HaiPaYanZi/Smart-Farm-Edge-Node/项目过程/原理图_conv.jpg

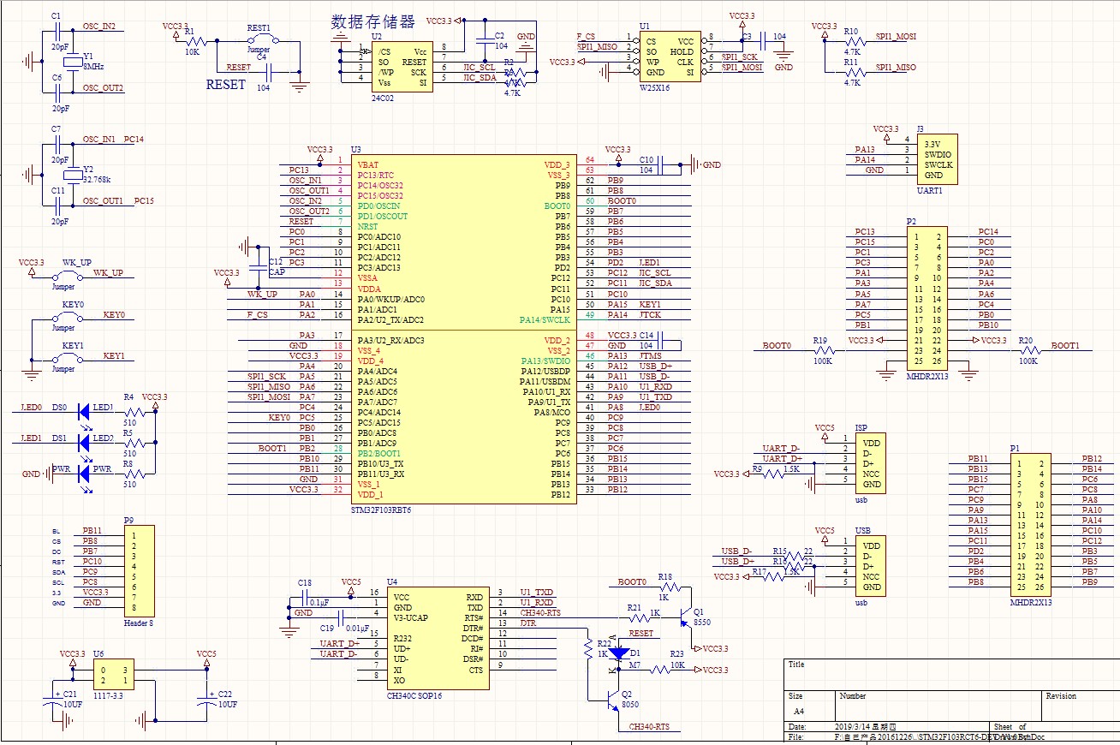
项目过程/原理图_conv.jpg
