HaiPaYanZi/Smart-Farm-Edge-Node/docs/03-详细设计说明书.md

# 详细设计说明书（LLD）

## 文档控制信息

| 项 | 内容 |
|---|---|
| 项目名称 | 温室环境智能控制节点 |
| 文档编号 | GWN-LLD-003 |
| 版本 | V1.0 |
| 作者 | 郑权 |
| 日期 | 2026-07-31 |
| 状态 | 已评审 |
| 上游文档 | 总体设计方案（GWN-HLD-002） |

---

## 1. 引言

本文档定义各模块的详细设计：算法、状态机、数据结构、关键函数接口与实现要点，编码以此为准。

---

## 2. PID 控制器设计（核心模块）

### 2.1 算法选择：位置式 PID + 抗积分饱和

```
u(k) = Kp·e(k) + Ki·Σe(i) + Kd·[e(k) - e(k-1)]
其中 e(k) = 目标温度 - 当前温度
输出 u(k) 限幅至 [0, 100]（%占空比）
```

### 2.2 实现要点

| 要点 | 实现 |
|---|---|
| 抗积分饱和 | 输出饱和（u=100 或 u=0）时，积分项停止累加（clamping 法） |
| 输出限幅 | 0~100%，双限幅 |
| 微分滤波（可选） | 对 e 做一阶低通（α=0.2）抑制噪声微分放大 |
| 整定方式 | 试凑法：先 P 后 I 再 D；现场演示"调 P 看风机抖动" |
| 采样/控制周期 | 控制任务 100ms 周期调用；与采集 200ms 解耦（PID 用最新快照） |
| 参数存储 | Kp: 0.1~50.0（默认 8.0）、Ki: 0.01~5.0（默认 0.3）、Kd: 0.1~20.0（默认 2.0），存 Flash，可远程改 |

### 2.3 数据结构

```c
typedef struct {
    float kp, ki, kd;
    float target;        // 目标温度(℃)
    float integral;      // 积分累加
    float prev_err;      // 上次误差(用于微分)
    float out;           // 输出 0~100
    float out_min, out_max; // 限幅(0,100)
    uint8_t  enabled;    // 使能
} pid_ctrl_t;
```

### 2.4 接口

```c
void pid_init(pid_ctrl_t *p, float kp, float ki, float kd);
float pid_update(pid_ctrl_t *p, float target, float feedback);
void pid_reset(pid_ctrl_t *p);   // 清积分(模式切换/参数变更时调用)
```

---

## 3. 规则引擎设计

### 3.1 规则表结构（周期 500ms 评估，控制任务内）

```c
typedef struct {
    uint16_t sensor_id;      // 输入源: SENSOR_TEMP/HUMI/LIGHT/SOIL
    float    threshold_hi;   // 上限阈值
    float    threshold_lo;   // 下限阈值
    float    hysteresis;     // 回差
    uint8_t  actuator_id;    // 执行器: ACT_FAN/ACT_LIGHT/ACT_PUMP
    uint8_t  action_hi;      // 高于上限的动作: 0无/1开/2关
    uint8_t  action_lo;      // 低于下限的动作
    uint8_t  mode;           // 0=禁用 1=使能(自动)
} rule_t;
```

### 3.2 预置规则（可在 Flash 中修改）

| 规则 | 输入 | 逻辑 | 执行器 |
|---|---|---|---|
| R1 通风（PID） | 温度 | PID 连续调节，滞回下限：温度<目标-2℃ 停转 | 风机 |
| R2 补光 | 光照 | <2000lx 开；>3000lx 关（回差 1000） | 补光灯 |
| R3 灌溉 | 土壤湿度 | <30% 开；>45% 关（回差 15） | 水泵 |

### 3.3 执行器输出映射

| 执行器 | 输出方式 | 手动模式替代 |
|---|---|---|
| 风机 | PID 输出 → 占空比 | 40006 直接写占空比 |
| 补光灯 | 规则开/关 → 占空比 80% 或 0% | 线圈 00002 |
| 水泵 | 规则开/关 → GPIO | 线圈 00001 |

---

## 4. 堵转检测与故障管理

### 4.1 堵转检测逻辑（反馈任务 + 控制任务协作）

```
状态: NORMAL → 输出占空比>30% → 启动检测窗口(3s)
      3s 内累计霍尔脉冲 < 阈值(如 5 个) → 判定堵转
      → FAULT(堵转): 停机(占空比0) + 蜂鸣器报警 + Modbus 状态位置位
      → 10s 后自动重试: 重新启动 → 再堵转 → FAULT(严重) → 停止自动重试
```

### 4.2 传感器失效判定

- 软件 I2C 读取失败连续 5 次（≈1s）→ 该传感器标记失效；
- 温度传感器失效 → 进入安全态：风机 30% 固定占空比（SAF2 哲学）；
- 光照/土壤失效 → 对应规则禁用，其余继续运行（降级）；
- 全部传感器失效 → FAULT(致命) → 复位进待机。

### 4.3 故障等级与状态字（上报 Modbus 30007）

```
bit0: 模式自动  bit1: 模式手动  bit2: 待机  bit3: 故障中  bit4: 恢复中
bit5: 堵转     bit6: 传感器失效  bit7: 上联断线  bit8: SD失败
```

---

## 5. Modbus 从机设计（FreeModbus 移植要点）

### 5.1 移植要点

- `eMBInit(MB_RTU, addr, 0, 9600, MB_PAR_NONE)`；
- RS485 DE 方向控制：UART TX 完成回调中置位/清零 DE（PA8）；
- `eMBPoll()` 放 Modbus 任务主循环，周期 ≥1ms；
- 保持寄存器/输入寄存器数组：`usRegHoldingBuf[16]`、`usRegInputBuf[8]`，读写回调里同步快照/参数区（互斥量保护）；
- **写回调中禁止执行耗时操作**：只更新参数区标志，实际生效由控制任务下次周期加载。

### 5.2 寄存器读写回调

```c
eMBErrorCode eMBRegHoldingCB(UCHAR *pucRegBuffer, USHORT usAddress,
                             USHORT usNRegs, eMBRegisterMode eMode);
// usAddress 为 0 基偏移，对应寄存器表 C1 文档
```

---

## 6. 数据存储设计

### 6.1 参数区（内部 Flash，模拟 NVS）

```
Flash 页4 (0x0800F000) 参数区1  | 页5 参数区2  ← 双页轮换，防掉电写坏
布局: 头(magic 0xA5A5 + crc16 + version) + 参数结构体
参数结构体: PID×3 + 目标温度 + 各阈值/回差 + 模式 + 从站地址 + 版本号
```

> 勘误(V1.2)：RCT6 为高密度器件，Flash 页大小 2KB，"页4/页5"应为"第 30/31 页"
> (0x0800F000/0x0800F800)。实现按地址执行，与程序区(约 40KB 内)远离，互不干扰。

写策略：Modbus 修改参数 → 置 dirty 标志 → 控制任务空闲时批量写，写前关中断。

### 6.2 SD 卡日志格式（CSV，按天分文件）

```
2026-07-31.csv
时间戳,温度,湿度,光照,土壤,实际转速,目标转速,模式,状态字,事件
2026-07-31 14:00:01,28.4,65.2,3200,41,1200,1500,AUTO,0x0000,-
2026-07-31 14:00:05,28.9,64.8,3210,40,1500,1500,AUTO,0x0020,FAN_STALL
```

- 写入：日志队列攒 16 条 → 一次性 f_write；
- 滚动：单文件 >512KB 时新建当天第 2 个文件。

---

## 7. OLED 显示设计（SSD1306）

| 页 | 内容 |
|---|---|
| 主页面 | 温度/湿度/光照/土壤 四行实时值 |
| 控制页 | 目标转速/实际转速/占空比/模式 |
| 状态页 | 状态字解析(自动/手动/故障...) + 报警闪烁 |

按键（板载 SW2/SW3，PC8/PC9）：KEY1 翻页，KEY2 切换 自动/手动。（V1.1 实物适配）

---

## 8. OTA 升级详细设计（见 C2 协议，此处为应用侧流程）

> 勘误 V1.3：升级触发寄存器为 **40020=0x5A5A**（原文 40011 与灌溉回差冲突，以 06 文档为准）；
> 页大小 2KB；升级通道 USART1（见 07 文档 V1.1 勘误）。

```
应用收到"升级指令"(40020=0x5A5A，或调试命令 ota)
  → 写升级标志区(0x08003000, upgrade_req=1) → 200ms 后软复位(Modbus 应答先发完)
Boot: 查标志 → 走升级流程 → 收分包写对侧区(2KB页) → CRC32校验 → 切标志 → 跳转
失败路径: 收包超时/校验失败 → 保持原区 → 故障码 0x0302 → 恢复运行
```

---

## 9. 关键函数接口汇总

| 模块 | 函数 | 说明 |
|---|---|---|
| 采集 | `void sensor_read_all(void)` | 200ms 周期，写入快照 |
| 控制 | `void control_tick(void)` | 100ms：状态机+规则+PID+输出 |
| 反馈 | `uint16_t fan_get_rpm(void)` | 霍尔计数换算 RPM |
| 故障 | `void fault_report(uint8_t level, uint16_t code)` | 分级处理+报警+日志 |
| 存储 | `void param_load(void) / param_save(void)` | Flash 参数读写 |
| 日志 | `void log_push(const char *fmt, ...)` | 进队列，日志任务落盘 |
| Modbus | `void modbus_task(void *arg)` | eMBPoll 循环 |
| 显示 | `void display_update(void)` | 500ms 刷新当前页 |

---

## 10. 变更记录

| 版本 | 日期 | 变更内容 | 变更人 |
|---|---|---|---|
| V1.0 | 2026-07-31 | 首次发布 | 郑权 |
| V1.1 | 2026-08-06 | 按键改用板载 SW2/SW3(PC8/PC9)，见 04 文档 V1.1 | 郑权 |
| V1.2 | 2026-08-14 | 节点 1.4/1.6 实现确认：① §2 PID 落地——clamping 抗积分饱和(输出饱和时积分**保持不动**而非清零)、滞回停转区间每拍 PID_Reset、温度失效安全态固定 30%；② §6.1 参数区落地——param.c 统一参数结构 + nvs.c 双区轮换(CRC16+序号+版本头，防抖 2s 落盘)，40008~40011 阈值收编参数区；③ §6.1 勘误——页号应为第 30/31 页(2KB/页) | 郑权 |
| V1.3 | 2026-08-15 | 节点 1.7 OTA 落地确认：① §8 升级触发寄存器勘误 40011→40020；② App 链接基址 = 分区+0x200(固件头段 512B)，向量表按运行地址自适应(链接器符号 Image$$ER_IROM1$$Base)；③ 升级请求写标志区 0x08003000(upgrade_req=1)，200ms 延时复位保证 Modbus 应答发出；④ Boot 8KB 寄存器级实现(USART1 通道/CRC16 帧校验/CRC32 全片校验/5s 超时回滚) | 郑权 |
