HaiPaYanZi/Smart-Farm-Edge-Node/docs/10-测试用例与报告.md

# 测试用例与测试报告

## 文档控制信息

| 项 | 内容 |
|---|---|
| 项目名称 | 温室环境智能控制节点 |
| 文档编号 | GWN-TR-010 |
| 版本 | V1.0 |
| 作者 | 郑权 |
| 日期 | 2026-07-31 |
| 状态 | 进行中（执行记录随测试推进填写） |
| 测试计划 | GWN-TP-009 |

> 说明：以下为用例全集。执行时复制"执行记录"列填写实际结果；未执行用例标记"待执行"。**报告中的测试数据是面试举证材料，务必真实记录。**

---

## 1. 功能测试用例（F 系列）

| 编号 | 用例 | 前置条件 | 步骤 | 预期结果 | 执行记录 |
|---|---|---|---|---|---|
| F01 | 温湿度采集 | 模块平台 | 上电观察 OLED/日志 | 温度/湿度读数与比对仪表偏差 <±0.5℃/±3%RH | |
| F02 | 光照采集 | 手电筒照度变化 | 遮挡/照射 BH1750 | 读数随光照线性变化，量程内不溢出 | |
| F03 | 土壤湿度采集 | 干燥/湿土 | 传感器插入不同湿度土 | 读数变化趋势正确，无跳变毛刺 | |
| F04 | 风机开环调速 | 手动模式 | 40006 写 20/50/80% | 占空比变化，转速随占空比上升，20kHz 无啸叫 | |
| F05 | PID 闭环 | AUTO 模式 | 目标 25℃，用热风枪升/降温度 | 温度趋近目标，稳态误差 ≤±1℃ | |
| F06 | 滞回停转 | 温度低于目标-2℃ | 观察风机 | 风机彻底停转，无频繁启停 | |
| F07 | 补光规则 | 手动改变光照 | 光照 <2000lx | 补光灯开，>3000lx 关 | |
| F08 | 灌溉规则 | 土壤湿度变化 | 湿度 <30% | 水泵继电器吸合，>45% 释放 | |
| F09 | 模式切换 | Modbus 写 40005 | 0/1/2 轮换 | OLED 与状态字同步变化，手动模式 PID 停算 | |
| F10 | Modbus 读输入 | ModbusPoll | 读 30001~30011 | 与 OLED 显示一致 | |
| F11 | Modbus 写参数 | 写 40001~40004 | 改 Kp/目标温度 | 下周期生效，掉电后保持 | |
| F12 | SD 日志 | 跑机 1h | 检查 SD 文件 | 每采集周期一条记录，CSV 格式正确 | |
| F13 | OLED 三页切换 | 按键 | 翻页 | 主/控制/状态页内容正确 | |
| F14 | 蜂鸣器报警 | 制造堵转 | 观察 | 报警声起，40021 写 1 后停止 | |
| F15 | 串口调试命令 | 串口工具 | info/param/set/fan | 命令生效，日志输出正常 | |

## 2. 边界测试用例（B 系列）

| 编号 | 用例 | 步骤 | 预期结果 | 执行记录 |
|---|---|---|---|---|
| B01 | PID 参数极限 | Kp=50 且 Ki=5 | 输出限幅 100%，无溢出无复位 | |
| B02 | 目标温度极限 | 写 -20/+60 | 系统正常，无异常行为 | |
| B03 | ADC 满量程 | PA0 短接 3.3V/GND | 读数 4095/0，无漂移 | |
| B04 | Modbus 地址越界 | 读 30099/写 40099 | 返回 ILLEGAL DATA ADDRESS | |
| B05 | 从站地址冲突 | 两台设备同地址 4 | 总线无死锁，轮询超时正常上报 | |
| B06 | 固件长度边界 | OTA 传 0 长度/超长固件 | 0x02 拒绝，0x03 长度超限 | |
| B07 | 日志滚动 | 写入 >512KB | 自动新建文件，旧文件保留 | |
| B08 | 485 线缆 100m | 长线收发 | 9600 正常通信，偶发误码可重试 | |

## 3. 异常测试用例（E 系列，故障注入）

| 编号 | 用例 | 注入方式 | 预期结果（SAF 编号） | 执行记录 |
|---|---|---|---|---|
| E01 | 拔温度传感器 | 运行中拔 I2C 线 | <5s 入安全态：风机 30%，状态字 bit6，故障码 0x0101（SAF3/SAF2） | |
| E02 | 拔全部传感器 | 运行中拔 I2C+ADC | FAULT(致命)→复位→待机（SAF2） | |
| E03 | 风机堵转 | 运行中手刹扇叶 | 停机+报警+状态字 bit5，10s 自动重试 1 次，仍堵转→停重试（SAF4） | |
| E04 | Modbus 断线 | 拔 RS485 线 | 节点自治运行≥24h，状态字 bit7 置位（SAF2/PERF5） | |
| E05 | 断电重启 | 运行 30min 断电 | 重启 <30s 恢复原模式，参数不丢，日志断点后继续（SAF6/PERF6） | |
| E06 | 掉电过程写参数 | 写参数瞬间断电 | 参数区双页轮换不损坏，重启校验通过（SAF6） | |
| E07 | OTA 中断电 | 传输 50% 断电重启（细化步骤见 9.2） | 原分区正常启动，活动分区不变（SAF8） | 待执行 |
| E08 | OTA 传坏固件 | CRC 错误包（细化步骤见 9.3） | 校验失败回滚，旧版本正常运行（SAF8） | 部分验证¹ |
| E09 | 看门狗注入 | 人为死循环（测试钩子） | IWDG 复位 <2s，重启进待机（SAF5/PERF10） | |
| E10 | SD 卡拔出 | 运行中拔卡 | 写失败计数+状态字 bit8，系统继续运行，插回恢复 | |

> ¹ E08 部分验证说明：CRC 校验失败 → 回滚旧分区 → 旧系统正常执行的"回滚行为"在 OTA 实测排障中已多次实跑（栈溢出污染数据、firmware_valid 误比较两起 bug 的每次 verify fail 后均正确回滚到 A 区并正常运行）；但按 9.3 标准注入流程完整执行、以及 fail_code=0x0302 标记路径的专项验证，尚未进行（待执行）。

## 4. 可靠性测试用例（R 系列）

| 编号 | 用例 | 方法 | 通过标准 | 执行记录 |
|---|---|---|---|---|
| R01 | 24h 连续跑机 | AUTO 模式恒温环境 | 无死机/无看门狗复位，日志零丢失（PERF8） | |
| R02 | 温度循环 | 热风枪 20℃↔40℃ 循环 4h | PID 全程收敛无振荡 | |
| R03 | 反复断电 | 100 次断电/上电 | 每次重启 <30s，参数始终完好 | |
| R04 | 重复 OTA | 连续 20 次升级 | 成功率 ≥99%，回滚路径正确（PERF9） | |
| R05 | 总线干扰 | 485 线并启停继电器 | 无死锁，误码可恢复 | |

## 5. 硬件测试用例（H 系列，底板自研电路）

| 编号 | 用例 | 方法 | 通过标准 | 执行记录 |
|---|---|---|---|---|
| H01 | 12V→5V 精度 | 万用表实测，负载 1A | 5.0V ±3%，纹波 <50mV | |
| H02 | 电源满载温升 | 满载 30min 热成像 | MP1584 温升 <40℃ | |
| H03 | 蜂鸣器电路 | 触发鸣叫/关闭 | 鸣叫正常，关闭无残留声 | |
| H04 | RS485 电路 | 与 USB转RS485 对收 | 1KB 数据无错码 | |
| H05 | 电机驱动 | 20~100% 调速 | 调速平滑，无啸叫，堵转电流受限 | |
| H06 | 继电器电路 | 100 次通断 | 动作可靠，续流正常（触点无拉弧） | |
| H07 | 防反接 | 反接 12V | 保险丝熔断或保护，板子无损伤 | |
| H08 | 485 120Ω 匹配 | 开/合跳线对比 | 合上后波形振铃明显减小 | |

## 6. 性能指标汇总表（对照 SRS §4）

| 编号 | 指标 | 目标值 | 实测值 | 结论 | 执行记录 |
|---|---|---|---|---|---|
| PERF1 | 采集周期 | 200ms±20% | | | |
| PERF2 | 控制周期 | 100ms±20% | | | |
| PERF3 | PID 稳态误差 | ≤±1℃ | | | |
| PERF4 | Modbus 响应 | <100ms | | | |
| PERF5 | 断网自治 | ≥24h | | | |
| PERF6 | 掉电恢复 | <30s | | | |
| PERF7 | 传感器失效检测 | <5s | | | |
| PERF8 | 日志零丢失 | 24h | | | |
| PERF9 | OTA 成功率 | ≥99% | | | |
| PERF10 | 看门狗恢复 | <2s | | | |

## 7. 缺陷登记表

| 编号 | 缺陷描述 | 复现步骤 | 等级 | 状态 | 修复版本 |
|---|---|---|---|---|---|
| DEF-001 | （示例）I2C 偶发读失败 | 总线 30cm 线缆连续读 200 次 | B | 已修复 | V1.1.0 |
| | | | | | |

## 8. 测试总结（完成后填写）

- 通过率：F ____% / B ____% / E ____% / H ____%
- 未闭环缺陷数：____（A/B 级不允许发布）
- 是否满足测试通过准则：□ 是 □ 否
- 签名/日期：____________

---

## 9. OTA 回滚测试专项（E07 / E08 细化步骤与预期）

> 本专项为 OTA 双分区升级（阶段 5）验收的收尾项，2026-08-18 起列为后期安排。

### 9.1 背景：回滚路径的验证现状

- **已验证（实跑）**：OTA 排障过程中，每次 `verify fail` 后 Boot 均正确回滚旧分区并正常运行（栈溢出污染数据、firmware_valid 误比较两起 bug 的现场即 E08 回滚行为的实际复现）；
- **未验证**：E07（传输中断）场景未实跑；E08 标准注入流程（改坏一字节重新打包）未完整执行；`fail_code=0x0302` 标记路径未专项验证；
- 两条回滚路径的故障码差异见 9.4。

### 9.2 E07 OTA 传输中断回滚（传输 50% 断电）

| 项 | 内容 |
|---|---|
| 前置 | 系统正常运行；置位 OTA（Modbus 写 40020=0x5A5A 或调试命令 ota）→ 设备进升级模式 `waiting host`；关闭串口助手（占用串口） |
| 步骤 1 | 运行 `%PY% ota_tool.py COMx fw_package.bin` |
| 步骤 2 | [3/6] 数据进度约 40%~60% 时，按板子复位键（等效"传输中断电"；真实断电可拔 USB 重插） |
| 预期 1 | 工具端：连续超时后报错退出（属预期，模拟断电） |
| 预期 2 | 复位后 Boot 读标志区 `upgrade_req=1`（残留）→ 打印 `OTA: upgrade requested, enter upgrade mode` → 进升级模式 |
| 预期 3 | 5s 内无主机握手 → 超时回滚（清升级请求 → 软复位） |
| 预期 4 | 复位后态 0 启动：打印 `OTA: part X valid, fail=00 00`（活动分区不变），App 正常运行，传感器/Modbus 正常 |
| 验证标准 | ① 活动分区与升级前一致；② 旧系统功能完好；③ 可再次正常升级（半截脏数据下次全擦重写，无残留影响） |

### 9.3 E08 OTA 传坏固件（CRC 校验失败回滚）

| 项 | 内容 |
|---|---|
| 前置 | 系统正常运行；用 pack_ota.py 打好正常包，复制一份为坏包 |
| 步骤 1 | 改坏包：脚本把坏包数据区中间一字节 XOR 0xFF（**不改头 crc32 字段**——期望值保持不变，设备侧重算才能对不上） |
| 步骤 2 | 置位 OTA → 关闭串口助手 → 运行 `%PY% ota_tool.py COMx bad_package.bin` |
| 预期 1 | [5/6]：Boot 读 Flash 重算 CRC32 ≠ 头字段期望值 → 打印 `OTA: verify fail local=xxxxxxxx` → 应答失败 → 工具报 `[错误] 设备 CRC32 校验不通过` 并退出 |
| 预期 2 | 0x06 未执行 → 标志区未写（无 upgrade_req=2）→ 设备留在升级模式 → 5s 超时回滚 → 复位 → 旧分区启动 |
| 预期 3 | 串口助手观察：`OTA: part X valid, fail=00 00`（回滚路径故障码为 0，见 9.4）→ App 正常运行 |
| 验证标准 | ① 校验失败被拒绝（不写标志区）；② 旧系统完好；③ 用正常包重新升级成功（坏包无残留影响） |

### 9.4 故障码 0x0302 的触发条件（技术备注）

- `fail_code=0x0302` 只在**态 2 复验失败**时写入（main.c：0x06 已执行、标志区已写 upgrade_req=2、复位后复验不过 → 回滚并置 0x0302）；
- [5/6] 校验失败（E08 场景）**不置 0x0302**——此时 0x06 未执行、标志区未写，走的是升级模式 5s 超时回滚（fail_code=0），启动日志显示 `fail=00 00`；
- 因此 0x0302 的正常触发需要"校验已通过、数据随后损坏"，黑盒难以构造；后期如需专项验证，二选一：
  - a) 升级成功后用串口 ISP 烧录工具破坏新分区数据 → 复位 → 态 2 复验失败 → 观察 `fail=03 02` 与回滚；
  - b) Boot 加临时测试钩子（handle_verify 通过后故意改错写入标志区的 new_crc32），测完还原代码。

### 9.5 执行记录

| 用例 | 状态 | 执行时间 | 结果摘要 |
|---|---|---|---|
| E07 | 待执行 | - | - |
| E08 | 部分验证 | 2026-08 排障期 | 回滚行为已多次实跑通过；标准注入流程与 0x0302 标记验证待执行 |

## 10. 变更记录

| 版本 | 日期 | 变更内容 | 变更人 |
|---|---|---|---|
| V1.0 | 2026-07-31 | 首次发布（用例全集） | 郑权 |
| V1.1 | 2026-08-18 | 细化 E07/E08 回滚测试步骤与预期（第 9 节）；登记 OTA 排障期回滚行为已部分验证 | 郑权 |
