HaiPaYanZi/Smart-Farm-Edge-Node/docs/11-项目实现流程.md

# 项目实现流程（任务节点版）

## 文档控制信息

| 项 | 内容 |
|---|---|
| 项目名称 | 温室环境智能控制节点 |
| 文档编号 | GWN-PLN-011 |
| 版本 | V1.0 |
| 日期 | 2026-07-31 |
| 状态 | 已发布（执行主线） |
| 约束 | 按任务节点推进，**不设固定时间**；每个节点以【出口条件】判定完成 |

> 执行原则：**前一个节点出口条件未达成，不进入下一个节点**。每个节点的产出物必须入库（git）并可追溯。

---

## 0. 总体流程图

```
[节点0 采购与准备]──→[节点1 模块平台开发]──→[节点2 自研电路验证]──→[节点3 底板设计适配]──→[节点4 集成收尾]
       │                    │                     │                     │                    │
   采购清单              节点1.1→1.7           5 块电路逐块验证      原理图→打样→焊接       GEC6818/OTA/可靠性
   git/环境准备          F系列用例               H系列用例            整机回归                R系列+归档
```

**采购贯穿流程的三批次**（见 §7 采购环节，可并行下单，不阻塞主链）。

---

## 节点0：采购与环境准备（启动节点）

| 项 | 内容 |
|---|---|
| 入口条件 | 文档体系 10 份齐备（已交付） |
| 任务清单 | 0.1 按 §7 采购清单**第一批**一次下单（模块+工具+核心板） |
| | 0.2 环境搭建：Keil uVision5 + STM32CubeMX + ST-Link 驱动 + VSCode/PlatformIO 双环境 |
| | 0.3 git 仓库初始化（按《05-配置管理规范》目录结构），docs/ 入库 |
| | 0.4 工程骨架：CubeMX 生成 HAL 工程（72MHz 时钟、USART1/2、TIM3、ADC1、SPI2、SWD） |
| | 0.5 冒烟验证：点灯 + printf 串口输出 + 下载正常 |
| 产出物 | 采购订单/到货清单、git 仓库（首提交）、可编译可烧录的工程骨架 |
| 出口条件 | ✅ 所有模块到货且上电验收正常；✅ 双环境均能编译烧录；✅ 工程骨架跑通 |

---

## 节点1：模块平台开发（软件全功能，面包板）

> 全部软件功能在此节点完成，硬件用面包板+模块。**本节点是项目主体。**

| 子节点 | 任务 | 产出物 | 出口条件 |
|---|---|---|---|
| 1.1 显示与调试 | OLED(SSD1306) 驱动、三页界面框架、调试命令处理 | ssd1306.c、调试口可交互 | OLED 显示正常，串口命令可用 |
| 1.2 传感器采集 | 软件 I2C 驱动 → AHT20/BH1750；ADC → 土壤湿度；滑动滤波+标定 | aht20.c/bh1750.c/bsp_adc.c | 三路数据 OLED 实时显示，与比对仪表偏差达标（F01~F03） |
| 1.3 执行器开环 | TIM3 双路 PWM（风机/补光）、继电器、蜂鸣器、霍尔 EXTI 测速 | bsp_pwm.c/bsp_gpio.c/测速模块 | 手动命令驱动各执行器正常（F04）；转速读数合理 |
| 1.4 控制核心 | PID（抗积分饱和/限幅/滞回）、规则引擎（补光/灌溉）、堵转检测 | pid.c/task_control.c | 温度 PID 闭环稳态 ≤±1℃（F05~F08）；堵转触发报警（F14） |
| 1.5 RTOS 化 | FreeRTOS 六任务化：采集/控制/反馈/Modbus/显示/日志；队列+互斥+快照区 | 全部 task_*.c | 任务化后行为与裸机一致，优先级抢占正确（PERF1/2 达标） |
| 1.6 存储与 Modbus | FatFS+SD 日志；FreeModbus 从机移植（寄存器表按《06》） | fatfs 移植/modbus 移植 | SD 日志格式正确（F12）；ModbusPoll 读写全部寄存器通过（F10/F11） |
| 1.7 OTA 机制 | Bootloader 工程（分区/跳转/回滚）、升级协议栈、PC 升级工具（串口直连） | boot/ 工程、tools/ota_tool.py | 升级/断电回滚/坏固件拒绝全部通过（E07/E08、PERF9） |

**节点1 整体出口条件**：功能用例 F01~F15 全部通过；边界用例 B 系列通过；异常用例 E01~E06 通过。

---

## 节点2：自研电路验证（洞洞板，逐块替换模块）

> 参照《08-硬件设计说明》§3 顺序，**每块电路验证通过才替换对应模块，未验证不上底板。**

| 子节点 | 任务 | 验证方法 | 出口条件 |
|---|---|---|---|
| 2.1 蜂鸣器电路 | S8050 开关电路焊接 | 触发鸣叫/关闭无残留声 | H03 通过 |
| 2.2 12V→5V 降压 | MP1584 电路焊接 | 万用表 5V±3%、满载温升<40℃ | H01/H02 通过 |
| 2.3 RS485 电路 | MAX3485 电路焊接 | 与 USB转RS485 对收 1KB 无错码 | H04 通过 |
| 2.4 电机驱动电路 | DRV8833 芯片电路焊接 | 20~100% 调速平滑、堵转电流受限 | H05 通过 |
| 2.5 继电器电路 | S8050+续流二极管焊接 | 100 次通断可靠、无拉弧 | H06 通过 |

**节点2 整体出口条件**：H01~H08 硬件用例全部通过；模块平台功能在"替换后的自研电路"上全量回归（F 系列重跑）。

---

## 节点3：底板设计与适配（PCB 打样）

| 子节点 | 任务 | 产出物 | 出口条件 |
|---|---|---|---|
| 3.1 原理图设计 | 嘉立创EDA：电源+485+驱动+继电器+接口排针，引脚**严格按《04》冻结表** | 原理图 | 对照《08》§5 评审清单逐项确认 |
| 3.2 Layout 与打样 | 2 层板布局布线（≤100×100mm）、评审、下单打样 | Gerber/打样单 | 评审清单全勾选，下单回执 |
| 3.3 焊接调试 | 到板焊接 → 核心板插底板上电 → 逐功能适配（先电源后外设） | 底板整机 | 底板各功能与模块平台行为一致 |
| 3.4 整机回归 | 底板平台上 F/B/E 全量重跑 + H 系列 | 回归记录 | 与模块平台结果一致，无新增缺陷 |

**节点3 整体出口条件**：底板整机全功能通过；H 系列全量通过；回归无 A/B 级缺陷。

---

## 节点4：集成与收尾

| 子节点 | 任务 | 产出物 | 出口条件 |
|---|---|---|---|
| 4.1 GEC6818 联调 | 网关作从站 4 挂入现有 HMI：轮询读数、远程配置、报警联动 | 联调记录（见 E3 联调指导） | 仪表盘显示网关数据，远程写参数生效 |
| 4.2 OTA 完整链路 | 若时间充裕：PC→TCP→GEC6818→RS485 中转升级 | 中转升级记录 | 中转通道升级成功（含回滚路径） |
| 4.3 可靠性专项 | 24h 跑机、100 次断电循环、20 次重复 OTA、总线干扰 | R01~R05 记录 | PERF5/8/9 达标 |
| 4.4 归档与交付 | 测试报告《10》闭环、性能指标汇总、简历项目描述、模拟面试 | 全部文档定稿 | 验收标准（SRS §8）全部达成 |

---

## 5. 节点依赖关系与并行性

```
节点0 ──┬──→ 节点1（主线，不可并行）
        └──→ （并行）节点2 的洞洞板焊接可在 1.6 之后提前开始
节点1.7 OTA ── 依赖 1.6 Modbus/存储（共享受控框架），不依赖节点2/3
节点3 打样等待期 ── 可并行推进 4.2 中转设计 / 文档补全
节点4.1 依赖：节点3 整机 + GEC6818 侧配置
```

**关键路径**：节点0 → 1 → 2 → 3 → 4.1 → 4.3。其余节点可插入并行。

---

## 6. 各节点与测试用例/文档映射

| 节点 | 执行用例 | 关联文档 |
|---|---|---|
| 节点1 | F 系列 + B 系列 + E01~E06 | 02/03/06/07 |
| 节点2 | H 系列 | 08 |
| 节点3 | H 全量 + F/B/E 回归 | 04/08 |
| 节点4 | R 系列 + 性能汇总 | 09/10 + SRS 验收 |

---

## 7. 采购环节（三个批次，尽早下单）

### 第一批（节点0，必须最早下单——物流是唯一可能卡主链的外部因素）

| 项 | 规格 | 数量 | 参考价 |
|---|---|---|---|
| STM32F103RCT6 系统板（绿深） | LQFP64，256KB，板载 CH340/RTC晶振/USB/按键×2/LED2 | 1 | ¥35 |
| AHT20 温湿度模块 | I2C | 1 | ¥8 |
| BH1750 光照模块 | I2C | 1 | ¥5 |
| 电容式土壤湿度模块 | 模拟输出 | 1 | ¥5 |
| 直流风机 | 5V，带扇叶 | 2（一备一用） | ¥10 |
| DRV8833 电机驱动模块 | 双 H 桥 | 1 | ¥8 |
| 霍尔测速模块+磁铁 | 开漏输出 | 1 | ¥5 |
| 0.96 寸 OLED | I2C，SSD1306 | 1 | ¥10 |
| MAX3485 模块 | RS485 | 2 | ¥8 |
| MicroSD 卡模块 | SPI | 1 | ¥5 |
| 继电器模块 | 1 路，5V | 1 | ¥5 |
| 蜂鸣器模块 | 有源 | 1 | ¥3 |
| USB转RS485 线 | FT232/CH340 | 1 | ¥15 |
| 面包板/杜邦线/万用表 | - | 1 套 | ¥20 |
| 双路 DC-DC 降压模块 | 12V入 → 5V+3.3V 双路独立输出（各3A） | 1 | ¥10~15 |
| 12V 2A 电源适配器 | DC 端子，模拟太阳能输入 | 1 | ¥12 |
| ST-Link V2 | 下载器 | 1（若无） | ¥12 |
| **小计** | | | **≈¥170** |

### 第二批（节点2 前下单：自研电路元件）

| 项 | 规格 | 参考价 |
|---|---|---|
| MP1584 | DC-DC 芯片 | ¥2 |
| MAX3485 ×2（备件） | RS485 芯片 | ¥4 |
| DRV8833 ×2 | 电机驱动芯片 | ¥6 |
| AMS1117-3.3 | LDO | ¥1 |
| S8050 ×10 | 三极管 | ¥2 |
| 1N4148/SS34/SMBJ6.0CA | 二极管/TVS | ¥3 |
| 10μH 功率电感 | 降压用 | ¥2 |
| 蜂鸣器/继电器/端子/排母/0603 阻容批次 | - | ¥20 |
| **小计** | | **≈¥40** |

### 第三批（节点3.2 下单：打样）

| 项 | 说明 | 费用 |
|---|---|---|
| 嘉立创 2 层板打样 | ≤100×100mm，5 片，免费额度内 | ¥0（超出 ¥20~30） |

**采购验收规则**：到货即按清单核对型号数量 → 关键模块（MAX3485/DRV8833/霍尔）上电验证 → 记录于节点0 产出物。**发现坏件立即补单，不等。**

---

## 8. 扩展方向(主线之外,不阻塞)

- **WiFi 上云(MQTT)+ 远程 OTA**:见《12-扩展方案-MQTT远程OTA.md》
- 依赖主线 1.7 的 bootloader 双分区机制(通道无关);ESP8266 挂 USART2
- 阶段:bootloader(主线 1.7)→ AT 透传 → MQTT → 远程 OTA

## 9. 变更记录

| 版本 | 日期 | 变更内容 | 变更人 |
|---|---|---|---|
| V1.0 | 2026-07-31 | 首次发布（任务节点版） |
| V1.1 | 2026-08-13 | 新增 §8 扩展方向(MQTT/远程 OTA),详见 12 文档 |
