HaiPaYanZi/Smart-Farm-Edge-Node/项目过程/板子引脚核对表.md

# 绿深 STM32 系统板 — 项目引脚核对表

> 用途:本项目(温室智能节点)用到的引脚 vs 板子实际连接,逐项核对
> 资料来源:官方资料包整理版(其他 AI 视图识别,准确度待核对)+ 实物观察
> 核对日期:2026-08-06 | 核对人:郑权
> 状态:⏳ 待核对

## 核对方法(只核 1 列)

| 列 | 要不要核 | 原因 |
|---|---|---|
| 引脚号 | 不核 | 芯片封装固定 |
| 引脚标识 | 不核 | 芯片手册固定 |
| **板载连接** | **✅ 只核这一列** | 唯一可能"坑"的地方:引脚上是否还焊着别的器件 |
| 标准复用功能 | 不核 | 芯片硬件固定,CubeMX 自动配,CubeMX 会配正确 |

## 必须核对表(项目用到的 12 个引脚)

| # | 引脚 | 项目功能 | 资料所述板载连接 | 核对结果 | 备注 |
|---|---|---|---|---|---|
| 1 | PA9/PA10 | RS485(USART1) | 排针引出,无外设 | ☐ | **最关键一项**:确认 CH340 不在 PA9/10 上 |
| 2 | PA2/PA3 | 调试口(USART2) | CH340 占用 | ☐ | 共存可用(printf 单向),确认 CH340 确实接这里 |
| 3 | PA6/PA7 | 风机/补光 PWM(TIM3) | 排针引出,无外设 | ☐ | |
| 4 | PA0 | 土壤湿度(ADC1_IN0) | 排针引出,无外设 | ☐ | |
| 5 | PA1 | 掉电检测(ADC1_IN1,建议) | 排针引出,无外设 | ☐ | |
| 6 | PB0 | 水泵继电器 | 排针引出,无外设 | ☐ | |
| 7 | PB1 | 霍尔测速(EXTI) | 排针引出,无外设 | ☐ | |
| 8 | PB4 | 蜂鸣器 | 排针引出(JTAG 脚,需关 JTAG) | ☐ | 关 JTAG 后可用 |
| 9 | PB6/PB7 | 软件 I2C(AHT20/BH1750/OLED) | 排针引出,无外设 | ☐ | |
| 10 | PB12~15 | SD 卡(SPI2) | 排针引出,无外设 | ☐ | |
| 11 | PB8/PB9 | CAN 预留 | 排针引出,无外设 | ☐ | 需重映射(CAN1 默认 PA11/12 被 USB 占) |
| 12 | PA8 | 485_DE | 排针引出,无外设 | ☐ | |

## LED 相关(3 项)

| # | 引脚 | 计划用途 | 资料所述板载连接 | 核对结果 | 备注 |
|---|---|---|---|---|---|
| 13 | PC13 | LED_电源 | 板载 LED0,推挽点亮 | ☐ | 确认高电平点亮 |
| 14 | PC14 | LED_上联 | 32.768K RTC 晶振(OSC32_IN) | ☐ | **看实物**:晶振是否真的焊了?(很多板子留空不焊) |
| 15 | PC15 | LED_运行 | 32.768K RTC 晶振(OSC32_OUT) | ☐ | 同上;没焊晶振则 PC14/15 可做 GPIO |

## 三个重点抽查(影响设计决策,务必确认)

1. **CH340 的 TXD/RXD 到底接 PA2/PA3 还是 PA9/PA10?**
   → 接 PA2/3:RS485 干净,调试口共存可用(最优)
   → 接 PA9/10:RS485 方案要改(换 UART4 或拆芯片)
2. **PC13 的 LED 是"高电平点亮"还是"低电平点亮"?**
   → 决定代码里 SET/RESET 哪一个是亮
3. **PC14/15 上 32.768K 晶振真的焊了吗?**
   → 没焊:PC14/15 就是两个自由 GPIO,LED 全用上,不用改设计
   → 焊了:LED_上联/运行改到其他空闲 PC 口(PC0~PC12 中挑)

## 运行时验证(代码兜底,终极手段)

肉眼核对完,还有一道保险:烧录"点灯+printf"冒烟程序后,用万用表量各排针电压验证:
- 配置为输出高的引脚,排针应量到 3.3V;输出低 → 0V
- 被板载外设意外拉低/拉高的引脚会暴露出来
- 这比反复看原理图快,而且验证的是**实物**而非图纸

## 核对结论(核对完成后填写)

- [ ] 全部勾完
- [ ] 芯片丝印确认为 STM32F103RCT6(已确认 ✓ 2026-08-06)
- [ ] 三个重点抽查结果已记录
- [ ] 若有差异,更新 04 引脚分配表(走变更评审)

## 实物核对结果(2026-08-06,亲眼看原理图)

**板上有外设的引脚(共 6 处):**
- PA8 → 板载 LED2(低电平点亮)
- PA9 → CH340G RXD / PA10 → CH340G TXD(USART1 被占!)
- PA11/PA12 → USB(TYPE-C:USBD-/USBD+)
- PC8 → SW2 按键 / PC9 → SW3 按键
- WK-UP 按键 → PA0
- 8M 晶振(PD0/PD1)+ 32.768K 晶振(PC14/PC15)均焊接 → **PC14/15 不可用**
- LED 共 2 个:PA8(LED2,低有效)+ 电源灯(直连 3.3V,不占引脚)

**其余引脚全部干净,仅排针引出。**

## 最终引脚分配(实物适配版,变更 5 处)

| 功能 | 引脚 | 变更 | 原因 |
|---|---|---|---|
| RS485 TX/RX | PB10/PB11(USART3) | 🔄 换 | 原 PA9/10 被 CH340 占 |
| 485_DE | PC0 | 🔄 换 | 原 PA8 被板载 LED 占 |
| 调试口 | PA2/PA3(USART2) | ✅ 不动 | CH340 在 PA9/10,此处干净 |
| 风机/补光 PWM | PA6/PA7(TIM3) | ✅ 不动 | |
| 水泵/蜂鸣器 | PB0/PB4 | ✅ 不动 | PB4 需关 JTAG |
| 软件 I2C | PB6/PB7 | ✅ 不动 | |
| 霍尔测速 | PB1(EXTI) | ✅ 不动 | |
| 土壤湿度 ADC | PA1(ADC1_IN1) | 🔄 换 | 原 PA0 被 WK-UP 占 |
| 掉电检测(预留) | PC2(ADC1_IN12) | 📌 新定 | |
| SD 卡 | PB12~15(SPI2) | ✅ 不动 | |
| CAN 预留 | PB8/PB9 | ✅ 不动 | 需 CAN1 重映射(PA11/12 被 USB 占) |
| LED_电源 | PA8(板载,低有效) | 🔄 换 | |
| LED_上联 | PC13(高有效) | 🔄 换 | |
| LED_运行 | PC1(高有效) | 🔄 换 | |

**CubeMX 改动清单**:删 USART1 → 加 USART3(PB10/11);ADC1 通道 IN0→IN1;GPIO:PA8 不配、PC0=DE、PC13/PC1=LED。其余不动。

PA8-LED2

//ch340g 接typec-1
PA9-CH340G RXD
PA10-CH340G TXD

//芯片直接type-2
PA11-- USBD-  --UD+ --TYPE-C DP1
PA12-- USBD+  --UD- --TYPE-C DN1

PC8 - SW2
PC9 - SW3
这些是我看到原理图上有外接外设的引脚，其他都没使用
引脚均有引出排针 ，
LED就只有两个 一个接了PA8，另一个直接接3.3电源，
按键4个 Reset wk-up Sw2K1 SW3K2
