HaiPaYanZi/Smart-Farm-Edge-Node/项目过程/遇到的问题.docx

#### 芯片烧了

ADC1引脚PA1-cannel1，我在使用开发板时，使用PA1接土壤传感器的AOUT输出端采集数据，但是采集到的是0值，，后面在芯片运行时将PA1与AOUT断开，使ADC悬空，采集悬空值，后面芯片就发烫烧了。

目前不知道是什么原因：

主要可能：PA1-接-AOUT的杜邦线，热插拔断开后杜邦线(还接着PA1)，一瞬间碰到了电源板的5V与12V，直接击穿了ESD 二极管-正向导通，导致芯片3.3V电源导轨被直接导到GND，过热，过压直接击穿ESD

次要原因：静电击穿，悬空震荡

出事前采集到的数据：

阔鵦痬?鵞00:00:00][I] runing

[00:00:00][I] Light: 0.833333

[00:00:00][I] Soil ADC raw: 2437

[00:00:00][I] Moisture: 78.879997

[00:00:00][I] Temperature: 28.859901, Humidity: 41.768837

[00:00:00][I] runing

[00:00:00][I] Light: 0.833333

[00:00:00][I] Soil ADC raw: 476

[00:00:00][I] Moisture: 91.000000

[00:00:00][I] Temperature: 28.842354, Humidity: 41.717625

[00:00:00][I] runing

[00:00:00][I] Light: 0.833333

[00:00:00][I] Soil ADC raw: 1745

[00:00:00][I] Moisture: 76.920006

[00:00:00][I] Temperature: 28.815842, Humidity: 41.730499

##### 操作规范：

接线铁律

1. 杜邦线一律断电插拔:接线先接 GND 和电源,再接信号;拔线顺序相反

2. 所有传感器信号线串 1kΩ 保护电阻再进 MCU 引脚

3. ADC 悬空引脚对 GND 并 10kΩ 下拉(泄放静电 + 防乱跳)

4. 传感器与 MCU 必须同电压供电(3.3V),禁止 5V/12V 上信号线

5. 带电操作时线头远离多路电源端子(12V/5V/3.3V 挨着的接线柱最危险)

6.禁止热插拔操作，就算支持热插拔也要禁止，必须断电接线和插拔

上电检查

1. 上电前对照引脚核对表复查接线,确认无信号线插到电源脚

2. 通电 3~5 秒内手摸芯片和 LDO:发烫立即断电

#### Usart2 重定义

/* printf 重定向到 USART2（Keil 需勾选 MicroLIB） */

//__CC_ARM与__GNUC__是编译器编译环境后缀，系统编译自带

#if defined(__CC_ARM) /* Keil MDK（MicroLIB)*/

int fputc(int ch, FILE *f)

{

HAL_UART_Transmit(&huart2, (uint8_t *)&ch, 1, 0xFFFF);

return ch;

}

#elif defined(__GNUC__) /* GCC 工具链（如 STM32CubeIDE） */

int _write(int fd, char *ptr, int len)

{

HAL_UART_Transmit(&huart2, (uint8_t *)ptr, len, 0xFFFF);

return len;

}

#endif

#### 日志调试编写

printf = 点外卖:菜单(格式串)+ 厨房(格式化)+ 送到家(stdout),一步到位

log_output = 自己做饭:买菜(vsnprintf 帮你切好菜)+ 自己调味(前缀/级别)+ 自己装盘(\r\n)+ 自己送到串口(HAL_UART_Transmit)

log_output(LOG_LEVEL_INFO, "TEMP=%d", 28);

│

├─① 前置:锁 + 级别过滤 ← printf 做不到

├─② snprintf(buf, "[%lu][%s] ", tick, "I") ← 自己写前缀

├─③ vsnprintf(buf+len, "TEMP=%d", 28) ← 借用 printf 的格式化引擎!

├─④ 拼接 "\r\n" + 截断保护 ← 自己写

├─⑤ HAL_UART_Transmit(buf) ← 输出到串口,不用 stdout

└─⑥ 释放锁 ← printf 做不到

#### ST-link接收不到设备

情况一：单独接主机可以识别，stlink加系统开发板接主机，主机就识别不了。

原因：劣质stlink带电能力弱或者系统开发板的负载开销多影响电压，导致stlink供电不稳，主机没法识别。

解决：系统开发板单独使用电源供电，但是注意stlink可以不接3.3v的引脚但是一定要接GND，不然没有参考电压/地，导致与主机识别不了与系统开发板烧录失败。

#### OELD显示问题：

其实这个图片的编码是我用官方的生成的，但是就是会x与y翻转，后面要使用AI识别一下将图片显示翻转回来：

1. 取模格式:取模器默认横向取模(高位在前),驱动要纵向取模(bit0=顶行)——不匹配就乱码,这是 ShowImage乱码的根因

2. 假动图:月薪猫_臭臭.webp 是静态图伪装 28 帧,真动图是后来从 mfuns 拿的 臭臭.gif 直接在网页保存不能直接保存到gif的动图，我是发给豆包让豆包去找的然后保存就行

3. 动画结构:8 帧数据 + 指针数组轮换,CAT_FRAME_COUNT 自动计数,以后加帧删帧只改帧表一行

#### freeRTOS系统Heap空间分配满

解决：根据芯片的SRAM空间，调大Heap，RCT6是48KB，一般可以调到16-28这个正常大项目的程度，注意开发阶段建议开一下CHECK_FOR_STACK_OVERFLOW = 任务栈溢出检测，Option1 简单快速检查 Option2=Method2 高覆盖率检测

#### OTA升级打包：

Python环境问题：原因找到了——你机器上有两个 Python，命令调的是 MSYS2 那个，pip 却装给了官方 Python312：

where python 结果:

1. D:\msys64\mingw64\bin\python.exe ← PATH 最前面，shell 实际用的它（没 pyserial）

2. ...\WindowsApps\python.exe ← 商店占位符

3. ...\Programs\Python\Python312\python.exe ← pip 刚装到它这里了（pyserial 3.5 ✓）

pip 和 python 指向了不同解释器（就是记忆里那个 MSYS2 Python 的坑，这次是反向的）。

解法：全程用官方 Python312 的全路径

在 cmd 里先定义个变量，省得每次敲一长串：

set PY=C:\Users\Administrator\AppData\Local\Programs\Python\Python312\python.exe

%PY% -c "import serial"

第二条没报错 = 通了（pyserial 3.5 就在那个环境里）。

之后打包和传输都用它：

cd /d D:\智慧农业控制节点项目\project\pc_tool

%PY% pack_ota.py ..\MDK-ARM\project.bin -o fw_1.8.0.bin

%PY% ota_tool.py COMx fw_1.8.0.bin

OTA打包（就是要生成project.bin文件，但是keil5默认不生成只能改）：

魔法棒-user

原理：后面就是使用Python环境运行python写的脚本（py_tool）程序将project.bin打包成“固件包”通过串口/ESP8266远程wifi传输到stm32芯片的分区里，到时重启stm32就会识别到升级标志，就会调整到保存分区启动，要是启动失败就会回到原分区启动。

现在遇到的问题就是串口助手可以正常发送ota命令触发他的接收固件包操作，115200也正常，回显文本也正常，但是就是运行python的传输命令的发现串口的连接表示建立了，但是发命令发写命令过去的时候就是回文乱码/没响应。

个人觉得：stm32的串口是正常的，但是就是主机拿到这个串口使用的时候就是不行，可能是主机python程序的问题

Keil5找到bin与axf文件：

● 对，一整行（一条命令）填进 Run #1 框里：让keil5找到 D:\Keil5\ARM\ARMCC\bin\fromelf.exe --bin --output C:\Users\Administrator\Desktop\智慧农业控制节点项目\project\MDK-ARM\project\project.bin

C:\Users\Administrator\Desktop\智慧农业控制节点项目\project\MDK-ARM\project\project.axf

它是一条命令行：fromelf.exe 参数 输出文件 输入文件——输出 bin 在前、输入 axf 在后，中间用空格分开，都在同一个框里。填完 F7。

配置和链接python环境：(当前会话有效)

set PY=C:\Users\Administrator\AppData\Local\Programs\Python\Python312\python.exe

%PY% -c "import serial"

进入项目工具目录：

cd C:\Users\Administrator\Desktop\智慧农业控制节点项目\project\pc_tool

打包固件命令：

%PY% pack_ota.py ..\MDK-ARM\project\project.bin -o fw_package.bin

OTA串口连接升级传输固件：

%PY% ota_tool.py COM14 fw_package.bin

#### OTA升级串口发送命令握手不成功：

OTA Boot v1.0, active part=

OTA: upgrade requested, enter upgrade mode

OTA: bootloader upgrade mode, waiting host...

现象：

1.ota_tool.py 一打开 COM14 → 板子复位 → Boot 重启中，工具发的握手帧落在重启窗口 丢失 → 无应答

2. 手动实验成功：助手一直开着（复位脉冲只发生一次，之后电平稳定），板子稳定在 waiting host，手动发帧自然成功

3. version\r\n 带换行——但这不是问题，板子被复位重启了，发什么都没用

原因：破案了！ 助手 RX 里出现的 "OTA Boot v1.0 → upgrade requested → waiting host" 就是决定性证据——打开端口这个动作本身复位了板子（DTR/RTS 电平跳变触发了 STM32 复位），Boot重启后读升级标志（upgrade_req=1 还在）→ 重新进升级模式 → 打印日志。这些日志留在 CH340 缓冲里，助手一打开就看到了。

解法：打开端口后立刻把 DTR/RTS 拉低（释放复位），等板子启动完成再发握手。写 v4 版诊断验证：

v4 的逻辑：打开 → 拉低 DTR/RTS（释放复位）→ 等 3 秒（板子启动完）→ 连发 5 次握手。

print(f"== 打开 {PORT} @ 115200 ==")

s = serial.Serial(PORT, 115200, timeout=0.2)

print(f" 打开时: DTR={int(s.dtr)} RTS={int(s.rts)}")

print("== 拉低 DTR/RTS(释放复位,避免打开瞬间的跳变持续影响板子) ==")

s.setDTR(False)

s.setRTS(False)

time.sleep(0.1)

print(f" 拉低后: DTR={int(s.dtr)} RTS={int(s.rts)}")

判读：握手成功! Boot 在线! → 机制确认，我把同样的处理加进 ota_tool.py，直接跑正式升级

解读：

你看到的 waiting host 日志是真的，但那是助手打开时打印的。ota_tool.py 一打开 COM14 的瞬间，pyserial 默认把 DTR/RTS 拉高（DTR=1 RTS=1）→ 绿深板的一键下载电路（DTR/RTS 经三极管接

STM32 复位脚）→ 把板子按在复位上 → 板子一直处于复位状态，永远起不来 → 工具发的握手帧全石沉大海。

- 手动实验成功：助手打开时电平变化只发生一次，之后稳定，板子正常活着，发帧就回

- 工具失败：每次打开都拉高 DTR/RTS → 板子被按死复位 → 3 次重试全无应答

- v4 成功：打开后立刻拉低 DTR/RTS → 板子释放复位 → 启动 → Boot 读 upgrade_req=1 → 进升级模式 → 握手成功

OTA升级CRC32校验失败

嫌疑排序：

1. Boot 的 CRC32 实现和 zlib 标准不一致（多项式/初值/最终异或任一不同，全片校验必败）——自测是 Python 模拟设备，Boot 真实 CRC32 代码从没被验证过

2. 最后一包不足 256B（49048 字节 = 191 包整 + 152 字节尾包，工具没补零，协议却写"每包必须写满 256B"）

3. Boot 写 Flash 的偏移错位

思考：

CRC32 算法实现看起来和 zlib 标准一致（0xEDB88320 / 初值 0xFFFFFFFF / 最终异或）——问题应该在读 Flash 的起始地址/长度或写入时的偏移/短包处理。而且 Boot 校验失败时会打印 OTA:verify fail local= + 实际 CRC32（475 行），这个值能告诉我们 Boot 算的是什么。读关键代码段：

handle_verify 从 target_addr + OTA_APP_OFFSET（0x08020200）读，长度 = fw_header.length（49048）——这个读取位置和 App 链接基址逻辑一致（bin 偏移 0 = 向量表 = 分区+0x200）。现在关键是对照写入侧：0x03 数据包写到哪、短包怎么处理。读 handle_data：

handle_data 的收包逻辑没问题（包号校验、页缓冲、残页 flush）。CRC32 算法也是标准 zlib。现在必须看 page_flush 的 Flash 写入地址——如果写入地址和 verify 读取地址（target_addr + OTA_APP_OFFSET）不一致，内容再对也对不上。读文件前半部分：

原因：

找到根因了！ 是 Flash 布局 + 擦除逻辑的确定性 bug——三次失败不是传输问题，是代码问题。

看关键代码：

handle_start（277-279 行）：固件头写到分区起始 0x08020000，但只擦了这一页（2KB：0x08020000~0x080207FF）

page_flush（206 行）：固件数据从 target_addr + OTA_APP_OFFSET 开始写 = 0x08020200——这个偏移 0x200 不是 2KB 页边界！

于是每 2KB 数据都横跨两个 Flash 页：

- 第 1 页数据 0x08020200~0x080209FF → 前 1536B 在页 0（已擦），后 512B 在页 1（没擦）

- 第 2 页数据 0x08020A00~0x080211FF → 又跨页 1 和页 2（页 2 没擦）……每一页都这样

写入未擦除的 Flash 页 → 硬件置 PGERR（编程错误）→ 但 flash_wait_done（boot_flash.c:27）只等 BSY 清零、根本不看 PGERR → 报"成功" → 后半段数据全部没写进去 → Flash 里是错的 → 全片

CRC32 必然不匹配。 顺便第一页数据 flush 时还把那 16B 固件头也擦掉了（同一页）——一石三鸟的 bug。

修复方案：

1. handle_start：一次性擦掉数据区覆盖的所有页（含头所在页），然后写头

2. page_flush：去掉每页擦除（已全擦），只写

3. flash_wait_done：加 PGERR 检查（防御，不再静默吞错误）

修复 1：handle_start 一次性擦净数据区所有页

修复 2：page_flush 去掉每页擦除，只写

修复 3：handle_data 检查 page_flush 返回值（不再静默吞错）

修复 4：handle_finish 检查残页写入返回值

修复 5：flash_wait_done 加 PGERR 检查（防御根因，不再静默吞错）

#### OTA升级注意一下刷写flash地址的start和end，注意运算

现象：C:\Users\Administrator\Desktop\智慧农业控制节点项目\project\pc_tool>%PY% ota_tool.py COM14 fw_package.bin

升级包: 版本 1.7.1, 49048 字节, 192 包

[1/6] 握手...

设备在线: 状态=0 当前版本=0.0 分区=A

目标分区: B

[2/6] 传输固件头...

固件头已接受

[3/6] 传输数据包...

进度: 40/192 包 (20%)

进度: 80/192 包 (41%)

进度: 120/192 包 (62%)

进度: 160/192 包 (83%)

进度: 192/192 包 (100%)

完成,耗时 6.4s

[4/6] 传输结束核对...

Traceback (most recent call last):

File "C:\Users\Administrator\Desktop\智慧农业控制节点项目\project\pc_tool\ota_tool.py", line 358, in <module>

main()

File "C:\Users\Administrator\Desktop\智慧农业控制节点项目\project\pc_tool\ota_tool.py", line 303, in main

_, data = client.wait_ack(CMD_FINISH, timeout=args.timeout)

^^^^^^^^^^^^^^^^^^^^^^^^^^^^^^^^^^^^^^^^^^^^^^^^^

File "C:\Users\Administrator\Desktop\智慧农业控制节点项目\project\pc_tool\ota_tool.py", line 164, in wait_ack

raise TimeoutError(f"应答 0x{ack_cmd:02X} 超时")

TimeoutError: 应答 0x84 超时

原因：

找到问题！而且这次的错误信息价值连城——证明 PGERR 检查生效了：

残页写入（最后一页 1944 字节）从 0x0802BA00 写到 0x0802C197——数据终点是 0x0802C198，但我的擦除循环终点算错了：

- 49048 = 0xBF98 → 数据终点 = 0x08020200 + 0xBF98 = 0x0802C198（不是我以为的 0x0802BFB8）

- 我的擦除循环 page_addr < data_end：最后擦到 0x0802BA00 所在页（页 23）就停了

- 数据最后 408 字节落在页 24（0x0802C000 起），这页没擦 → 残页写入跨进未擦除页 → PGERR → 新加的检查拒绝 → handle_finish 无应答 → 0x84 超时

解决：擦除边界要向上取整到页且含终点页

#### OTA升级CRC明明运算的方法都标准和正确，为什么就是校验不成功问题：

现象：数据写入和校验都过了，但升级后设备没切到 B 分区。

让AI更新ota_tool,用输出检测flash的内部start与end的地址偏移和页擦除对不对，再分段检测start与end之间的正确性检测。其实这个一般确定好start与end的地址都不会错，但是有这个检测步骤

问题原因：

抓到了！！OTA: verify fail, rollback old part... —— 态 2 复验失败，标志区写入没问题。而复验的两个条件里，firmware_crc_check（[5/6]同算法同范围，必过）基本排除，嫌疑集中在 firmware_valid(new_addr)——检查 B 区固件头的 CRC32。这个头 CRC 是 pack_ota.py 打包时算的，[5/6]只校验固件数据、从不校验头，所以这个字段从没被验证过。

先本地验证工具：C:/Users/Administrator/Desktop/智慧农业控制节点项目/project/pc_tool" && python -c "

● 实锤了！！

头内 crc32 字段: 0x339CB305 ← 这是固件数据的 CRC！

前12字节 zlib 算: 0x1DA762CC ← Boot firmware_valid 要的是这个

不一致!

pack_ota.py 把"固件数据 CRC"填进了头部的 crc32 字段，而 Boot 的 firmware_valid() 校验的是"头前 12 字节的 CRC"——两者定义冲突。 [5/6] 校验的是固件数据（用头字段 ✓通过），态 2 复验的 firmware_valid 校验头（必失败 → 回滚）。这个字段从 OTA 功能开发以来从没真正被 Boot 校验过，第一次全链路跑到态 2 就暴露了。

先看头部注释和打包脚本，确认设计意图再改：

uint32_t crc32; /* 固件数据 CRC32(不含头,PC 工具打包时计算) */

设计意图：头 crc32 字段 = 固件数据 CRC。pack_ota.py、ota_tool.py [5/6] 都没错——是 Boot 的 firmware_valid() 用错了（main.c:89-92 拿"头前 12 字节 CRC"和"固件数据

CRC"比较，必然不等）。而态 2 复验的 firmware_crc_check 已经对全片做 CRC 校验了，firmware_valid 里的头 CRC 检查纯属多余且错误。

先快速确认打包脚本，再修：

pack_ota.py 确认无误——头 crc32 = 固件数据 CRC，符合文档《05》§3.2 定义。bug 就在 Boot 的 firmware_valid()：它拿"头前 12 字节的 CRC"去比"固件数据CRC"，两个不同含义的值永远不等 → 态 2 复验必失败。

修复它——删掉这个错误比较， magic+length 足够防跳错，全片完整性本来就由 firmware_crc_check 负责：

梳理：

梳理一下这个 bug 的全貌——它是个"双用途冲突"：

ota_common.h:55 crc32 字段 = 固件数据 CRC ← pack_ota.py、工具 [5/6]、标志区 new_crc32 全按这个用main.c firmware_valid: 拿它和"头前 12 字节 CRC"比较 ← 唯一的错误用法

态 2 复验 firmware_valid(B) && firmware_crc_check(...) 里，前者永远返回 0 → 升级永远回滚。而 [5/6] 只校验固件数据不校验头，所以这个错误埋到现在第一次全链路跑态 2

才暴露。

修改：

1. main.c firmware_valid()：删掉错误的头 CRC 比较，只查 magic + 长度（防跳乱码区足够了；全片完整性由 [5/6] 和 firmware_crc_check 负责）

#### OTA升级CRC校验正常但是没有成功切换到分区B：

原因：flush_data[2048]数据 2KB 放动态栈上了（在局部函数里调用导致的没放在全局区域），但是2KB比较大，栈写入完后就向下生长，溢出到.bss数据段

解决：加static关键字，分配数据到.bss数据段（静态存储区）

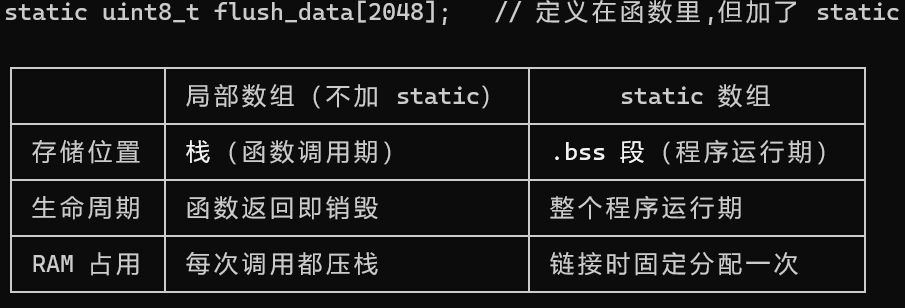
[picture p18: figure]

教训：以后创建的大数组与大数据，要加static或其他的放在全局，放在静态存储区

开发改进栈溢出请看知识点

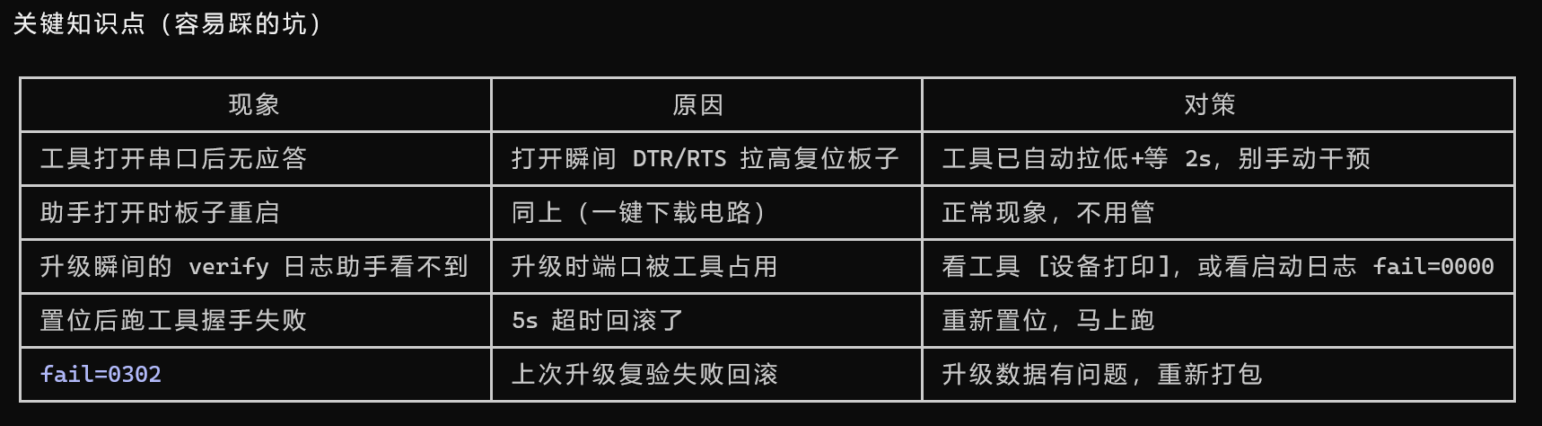
[picture p19: figure]

完整流程给你，可以直接抄进笔记：

OTA 升级完整步骤（PC 工具 + 串口助手配合）

第 1 步：编译烧录 Boot（改过代码才需要）

Keil 打开 Boot 工程 → 编译 → 一键下载烧录（串口 ISP）

第 2 步：编译 App

Keil 打开 App 工程 → 编译 → 生成 MDK-ARM\project\project.bin

第 3 步：打包升级包（要先连接号python环境）

%PY% pack_ota.py ..\MDK-ARM\project\project.bin -o fw_package.bin

预期：[完成] 固件版本 1.7.1, 长度 49048 字节, CRC32=0x...（CRC 每次编译不同）

第 4 步：置位（让设备进升级模式）

1. 串口助手连 COM14（115200）

2. 发 Modbus 写 40020=0x5A5A（或 App 的 ota 调试命令）

3. 助手看到：

OTA: upgrade requested, enter upgrade mode

OTA: bootloader upgrade mode, waiting host...

3. ⚠️ 置位后 5 秒内必须继续下一步，否则超时自动回滚

第 5 步：关掉串口助手！

⚠️ 不关助手，工具打不开端口（PermissionError）

第 6 步：跑升级工具

%PY% ota_tool.py COM14 fw_package.bin

预期输出：

[1/6] 握手... 设备在线: 版本=1.7.1 分区=B ← 重点！目标分区=A（交替）

[2/6]~[4/6] 全过

[5/6] 校验通过

[6/6] 执行升级...

[设备打印] ...OTA: verify ok, boot new part... ← 升级成功的证据！

握手无应答... ← 正常！已跳 App

第 7 步：开助手验证

重新打开助手（会触发板子复位，正常现象），看到：

OTA Boot v1.0, active part=

OTA: part A valid, fail=0000 ← 分区 A + 升级成功！

[00:00:00][I] runing ← App 日志

新增：

stack: peak=000003XXB ← 金丝雀新打印(Boot 的栈峰值)

[00:00:01][I] stack: msp peak=xxxB/1024B ← App 的 MSP 峰值

然后发 version 命令 → 显示 1.7.1 ✓

问题解答：

一、升级过程里到底有哪几个 CRC？


帧尾 CRC16 是每帧都有的，每发一帧重算一次；而固件头的 crc32 是整个固件算一次。这不是"两个 CRC 冲突"，而是分工不同：CRC16 管"这 20 几个字节传对没有"，CRC32 管"这49048 字节固件写对没有"。

2、 之前 bug 错在哪？

一句话：拿"头里存的值"去跟"头自己的字节"比。

看固件头 16B 结构：

offset 0 magic(4) "GWNM" ← 标识

offset 4 版本(4) 1.7.1 ← 版本

offset 8 length(4) 固件长度 ← 长度

offset 12 crc32(4) ═══> 存的是【固件数据】的 CRC32,不是头自身的!

而旧代码写的判断是：

boot_crc32(header, 12) == header->crc32

左边是代码现算的"头前 12 字节"的 CRC，右边是打包时算的"整个固件数据"的 CRC——这两个数学上就不可能相等，除非巧合碰撞。所以 firmware_valid 永远返回 0，态 2

复验必失败，升级必回滚。

根因就是设计文档和代码没对齐：ota_common.h:55 注释写得很清楚"crc32: 固件数据 CRC32(不含头,PC 工具打包时计算)"，main.c 却按"头自身 CRC"去理解它。

3、 为什么设计上"头里不存头自身的 CRC"？

因为校验资源要花在最容易错的地方：

1. 头 16B 太短太规整：magic 4 字节（碰撞概率 2⁻³²）+ length 范围检查（0~100KB），已经能挡住几乎所有"头损坏"的情况——头错一位，magic 几乎必变，或者 length

越界，立刻能查出来。

2. 固件数据是大头：几十 KB，历经 115200 波特率串口传输 + 逐页擦写，任何一字节出错都要能查出来——这才需要 CRC32 强校验。

3. 一个 crc32 字段只有 4 字节，存哪个更有价值？ 存数据 CRC。这就是文档 §3.2 的约定。

四、为什么 [5/6] 和态 2 要各验一次 CRC？

这两次是同一件事做两遍，但时机不同、失败后果不同：

[5/6] 校验 ← 升级模式中,数据刚写完 Flash,实时算

失败 → 工具中止,还可续传重来(低成本)

0x06 写标志区 upgrade_req=2 → 软复位

态 2 复验 ← 复位后,重新读 Flash 全片再算一遍

失败 → 已退出升级模式,只能回滚 0x0302(高成本)

中间隔了一次复位，多验一遍是为了防"标志区都写好了、数据却不对"这种极端情况（Flash

坏页、写标志区瞬间掉电等）。第一次错了能重来，第二次错了只能回滚——所以第二次必须更严格。

#### 串口命令发不出去（unknown cmd: pidwatchpidwatch...）

根因：串口助手没勾"发送新行"或者没写的时候没换行，接收代码只认 \r\n

解决：代码加 200ms 字符间隔超时判帧兜底（借鉴 Modbus 3.5T 思想）+ 你养成发换行的习惯

#### PID没根据阈值限制做出响应控制问题：

其实错误就是我们应该使用实际-目标值 = 误差，不要反。。

因为日常中一般都是实际高于目标这样才是正值，不然就负值，而且控制里也是负值也对应着不转就是冷了不要再吹了，正值就是好热开吹

找到真正的 bug 了——是 PID 误差的符号方向反了，不是模式、不是同步、不是滞回。推导给你看：

数学推导：为什么 out=0 是必然

代码链路全部验证过：写 40004 → Param_SetTarget 置 dirty（param.c:128）→ 控制任务每拍 Param_Sync 刷 g_pid.Target=30（param.c:384）→ 48.8℃ 不在滞回区间（48.8 > 30-2）→ 调PID_Update。

然后看 PID.c 第 52 行：

p->Error0 = p->Target - p->Actual; /* 误差 = 目标 - 实际 */

代入你的数据：目标 30、实际 48.8：

Error0 = 30 - 48.8 = -18.8 ← 负的!

out = Kp × Error0 = 5.13 × (-18.8) = -96.4

→ 低于 OutMin=0 → 被限幅钳到 0% ← 你看到的 out=0

温度比目标高（需要降温、风扇该转）→ 误差为负 → 输出为负 → 被 0 下限钳死 → 风扇永不转。

这个 PID 的符号约定是"加热器语义"（温度低于目标 → 正输出 → 加热）。但我们的风机是降温设备——温度高于目标才该转。方向反了。

错误p->Error0 = p->Target - p->Actual; //获取本次误差，目标值减实际值，即为误差值

正确p->Error0 = p->Actual - p->Target; //获取本次误差,实际值减目标值:温度高于目标→正误差→正输出(风机降温语义)

#### Modbus poll只有上电/复位时才会轮询采集一下设备采集数据问题：

使用到了keil5的断点调试（最大收获）

难题 4：Modbus 从站不应答

- 现象：reset 后第一次能更新数据，之后一直 timeout

- 排查过程：断点逐级收窄（RXNE→定时器启动→TIM2 中断→超时回调）→ Watch 看 TIM2->SR/DIER 交替变化，证明超时链完全正常 →

问题转向 FreeModbus 状态机 → 读源码发现 portserial.c 的 TC 收尾分支把接收中断 RXNE 一起关了，且全栈没有任何代码重开它

- 修复：一行——vMBPortSerialEnable(FALSE, FALSE) 改成 (TRUE, FALSE)，只关发送、保持接收开启

- 最有价值的一课：你亲手用寄存器证据推翻了"定时器链有问题"的假设——SR=0x1F↔0x1E、DIER=0x01↔0x00 的交替就是"溢出→ISR

消费→回调→下一帧重启"的健康心跳。排错就是一层层用证据把"正常"的部分划掉，剩下的就是病根

详细：

最后一击：看 TIM2 寄存器现场

断点打在 it.c 第 189 行（HAL_TIM_IRQHandler(&htim2); 这一行）——它是 TIM2_IRQHandler 进来后的第一件事。

命中断点后，在 Watch 窗口输入这两个寄存器名：

TIM2->SR

TIM2->DIER （调试看看寄存器的值，可以查数据手册也可以问AI查看每一位的意思和中断标志）后面证明是没问题的

eMBPoll 的调用者找到了：freertos.o(i.Modbus_Task) —— 有个 Modbus_Task 在调它。现在读三处关键代码确认嫌疑：

mbrtu.c 读到了关键信息——这个版本的判帧不在超时回调里，超时回调只发事件 EV_FRAME_RECEIVED，真正的判帧和应答在 eMBPoll里。而 eMBPoll 由 Modbus_Task 调用（map 文件证据：freertos.o(i.Modbus_Task) refers to mb.o(i.eMBPoll)）。继续读：

判帧在 eMBPoll 里（EV_FRAME_RECEIVED→CRC 校验→EV_EXECUTE→应答），但注意到 eMBPoll 结尾没有处理接收状态机回 IDLE 的else 分支——继续读 mbrtu.c 剩余部分和 portserial.c、Modbus_Task，确认状态机流转：

mbrtu.c 结尾读到了：xMBRTUTimerT35Expired 末尾 eRcvState = STATE_RX_IDLE（超时后回 IDLE ✓），而 portserial.c 的 TC收尾分支调了 vMBPortSerialEnable(FALSE, FALSE)——它把 RXNE 中断也关掉了。这是"第一次成功、之后timeout"的头号嫌疑。还要确认几个关键点：

pxMBFrameCBTransmitterEmpty = xMBRTUTransmitFSM（mb.c:153）确认了，全部证据链闭合——根因找到了，是一行移植代码的

bug。先修：

__HAL_UART_CLEAR_FLAG(&huart3, UART_FLAG_TC);/* 清 TC 标志(写 0 清) */

__HAL_UART_DISABLE_IT(&huart3, UART_IT_TC);/* 关 TC 中断 */

错误：vMBPortSerialEnable(FALSE, FALSE);/* 关收发中断 *////

正确：vMBPortSerialEnable(TRUE, FALSE);/*只关发送,接收必须保持开启:等下一帧请求 */

HAL_GPIO_WritePin(RS485_DE_GPIO_Port, RS485_DE_Pin, GPIO_PIN_RESET);/* DE 拉低:回接收*/

xMBPortEventPost(EV_FRAME_SENT);/*通知协议栈:帧发完(名字必须和 mbport.h 声明一致) */}

解析：根因：应答发完后，接收中断被"顺手"关死了

问题在 portserial.c 的 TC 收尾分支（第 130 行，刚改掉）：

/* ③ 发送完成:整个帧真正发完 */

if (TC 标志)

{

清 TC; 关 TC 中断;

vMBPortSerialEnable(FALSE, FALSE); // ← 原来是这行:关收发中断!

DE 拉低; // 回接收方向

xMBPortEventPost(EV_FRAME_SENT);

}

vMBPortSerialEnable(FALSE, FALSE) 两个参数：第一参数 rx_enable=FALSE = 关闭 RXNE

接收中断。作者本意是"发完了，关发送中断"，但顺手把接收也关了。

关键：整个 FreeModbus 代码里，没有任何地方会在下一次请求到来前重新打开 RXNE。 协议栈自己的重开动作（xMBRTUTransmitFSM

发完后的 vMBPortSerialEnable(TRUE, FALSE)）发生在同一次中断的 ② 分支，紧接着就被 ③ 分支又关掉了——③ 覆盖了 ②。

于是完整闭环：

reset → eMBRTUStart 开 RXNE（初始正常）

第1帧:8 字节收进来 → 判帧 → 应答完整发出 → TC 收尾 → DE 拉低 ✓ 但 RXNE 被关死 ✗

第2帧:字节到 USART3,但 RXNE 中断没开 → 协议栈一个字节都看不到

→ 定时器不重启 → 无判帧 → 无应答 → Modbus Poll 一直 timeout

再 reset → eMBRTUStart 又开一次 RXNE → 第一次又成功 → 又关死

这就是"我一 reset 就又更新数据了"的精确解释。

顺带讲清一个 F1 细节：发送链为什么没断（值得学）

你可能会问：② 分支里 TXE 中断发第一个字节后，代码走了 if (!pxMBFrameCBTransmitterEmpty()) 把 TXE 中断关了、TC中断开了（因为 FreeModbus 的返回值语义是"有没有事件要轮询"，移植作者当成了"还有没有字节"，语义错配）。按说发送链第一个字节后就断了，但应答却完整发出了——为什么？

因为 F1 的 TC 中断歪打正着接力了发送：

TC 中断进来 → ② 分支检查 TXE 标志(标志=1,DR 空)→ 又发一个字节 → 写 DR 顺手清了 TC→ 这个字节移出后 TC 又置位 → TC 中断再来 → ② 又发下一个字节……

也就是说除了第一个字节是 TXE 中断发的，后面每个字节都是 TC 中断进来时借 ②

分支发出去的。链路能跑，但语义是错的——这次不深究它（能跑就不动，避免引入新风险），你以后自己写 RS485收发时记住这个"三段接力"的设计意图就行。

#### Mricro SD卡模块检测调试：

SD 卡挂载失败（一下午，未解决，等硬件）

现象：sd: CMD0 fail, R1=0xFF，卡完全不应答

排查方法：把 Keil 调试器当穷人版逻辑分析仪——CRH 寄存器逐位解码（引脚配置全对）、CS 拉低后 IDR 回读自检、94 次 SPI

收发全 HAL_OK、碰电平实验（MISO 碰 GND/3.3V 看 IDR 变化）证明引脚活

结论：主机侧每一环都有硬证据闭环，嫌疑锁定 3 元模块（SN74HC125 电平转换链路）或卡本身

检测了：5V电源，接线，电路连接，SD卡类型，SD卡模块类型，SPI时序，SPI接线与接收与发送（keil5调试），SD卡的插拔，代码逻辑，

只能看新模组了

教训：软件证据链做满之后，就大胆怀疑硬件，别死磕代码（3个小时的教训）
