HaiPaYanZi/Smart-Farm-Edge-Node/项目过程/claude提升/图片识别.docx

### 路线 2（强烈推荐）：导出【立创 EDA 源码 JSON】

文件 → 导出 → 立创 EDA 文件源码（JSON）

这个 JSON 是完整工程快照：原理图所有元件、引脚、网络、元件参数（R=10k、C=0.1uF）、封装、LCSC 料号全部内置！ ✅ 巨大优势：

1. 一份文件同时包含【网表连接信息 + 元件参数】，不用分开合并 BOM；
2. 信息最全，不需要跨文件匹配位号，减少出错；
3. EasyEDA / 嘉立创通用，社区有现成 JSON 解析代码；
4. 后续扩展：还能提取 PCB 坐标，用来做 “去耦电容布局距离” 简易检查。

⚠️ 重点提醒： 标准版（网页老版）叫【立创 EDA 文件源码】；专业版 Pro 导出名称为【EasyEDA 格式 JSON】，是同一个东西。

嘉立创EDA原理图

↓ 导出【工程JSON】

Python解析脚本（核心）

1. 遍历所有元件：ref位号、型号、参数、封装

2. 解析全部网络：哪个引脚连接哪个Net

3. 过滤Logo、标注、无电气属性图形

4. 输出精简标准化JSON（喂给LLM的格式）

↓

拼接硬件审查Prompt（之前给你的嵌入式电路检查清单）

↓

调用DeepSeek V4 Flash API

↓

输出原理图风险审查报告

### ⚠️ 需要规避的坑（非常关键）

1. 分页原理图（多 Sheet） 如果你的工程是多张原理图分页，导出 JSON 一定要确认全部图纸包含在内，脚本需要递归解析所有子图纸，否则丢失跨页信号网络。
2. 分立器件参数存放位置 电阻电容的阻值存在value字段，芯片型号在name，解析脚本不要搞混。
3. 离线无法导出 嘉立创 EDA 是云端工具，必须登录网页导出 JSON / 网表，不能本地离线读取.epro工程；

KiCad 可以完全本地文件解析，这是 KiCad 唯一优势。

## 补充：现成工具资源

Github 存在开源解析库：easyeda-parser，可以直接解析嘉立创 EDA 导出的 JSON，免去从零写解析代码。 解析完成后，输出统一结构：

{

"components": [{"ref":"R1","model":"0.1uF","footprint":"0603"}],

"nets": [{"net_name":"VCC3V3","pins":["U1.VDD","C1.Pin1"]}]

}
