HaiPaYanZi/Smart-Farm-Edge-Node/docs/06-Modbus寄存器表.md

# Modbus 寄存器表（协议定义）

## 文档控制信息

| 项 | 内容 |
|---|---|
| 项目名称 | 温室环境智能控制节点 |
| 文档编号 | GWN-MBR-006 |
| 版本 | V1.0 |
| 作者 | 郑权 |
| 日期 | 2026-07-31 |
| 状态 | 已评审（版本变更须走 CM 流程） |
| 传输 | RS485, Modbus RTU, 9600bps/8N1, 从站地址=4（可配置 40010） |

---

## 1. 通用约定

- 寄存器地址采用 **PLC 地址（1 基）** 表述，协议帧内为 0 基偏移；
- 16 位无符号数，高字节在前（大端）；
- 浮点参数用 **整数编码**：温度/转速 ×10，PID 参数 ×100，避免浮点在线传输；
- 写寄存器立即生效并置"参数变更标志"，控制任务下个周期加载，同时触发 Flash 保存（防掉电丢失）。

---

## 2. 输入寄存器（功能码 04，只读）

| PLC 地址 | 协议偏移 | 名称 | 编码 | 说明 |
|---|---|---|---|---|
| 30001 | 0 | 空气温度 | ×10, 有符号 | 例: 284 = 28.4℃ |
| 30002 | 1 | 空气湿度 | ×10 | 例: 652 = 65.2%RH |
| 30003 | 2 | 光照强度 | 1 lx | 0~65535 |
| 30004 | 3 | 土壤湿度 | 0.1% | 例: 410 = 41.0% |
| 30005 | 4 | 风机实际转速 | 1 RPM | 霍尔测速换算 |
| 30006 | 5 | 目标转速 | ×10 | PID 输出映射 |
| 30007 | 6 | 运行状态字 | 位定义 | 见 §4 |
| 30008 | 7 | 固件版本 | BCD | 0x0101 = V1.1 |
| 30009 | 8 | 上电累计运行秒数 | 1s | 高 16 位（溢出翻转归零） |
| 30010 | 9 | 故障代码 | 见 §5 | 0 = 无故障 |
| 30011 | 10 | 传感器状态 | 位定义 | bit0 温度 bit1 湿度 bit2 光照 bit3 土壤 bit4 转速（1=正常） |

---

## 3. 保持寄存器（功能码 03/06/16，可读写）

### 3.1 控制参数

| PLC 地址 | 协议偏移 | 名称 | 编码 | 默认值 | 说明 |
|---|---|---|---|---|---|
| 40001 | 0 | PID Kp | ×100 | 800 | 0.1~50.0 |
| 40002 | 1 | PID Ki | ×100 | 30 | 0.01~5.0 |
| 40003 | 2 | PID Kd | ×100 | 200 | 0.1~20.0 |
| 40004 | 3 | 目标温度 | ×10, 有符号 | 250 | 25.0℃ |
| 40005 | 4 | 控制模式 | 0/1/2 | 0 | 0=自动 1=手动 2=待机 |
| 40006 | 5 | 手动风机占空比 | 0.1% | 500 | 50.0%，手动模式有效 |
| 40007 | 6 | 风机滞回下限 | ×10 | 200 | 温度 < 目标-2.0℃ 停转 |
| 40008 | 7 | 补光阈值 | 1 lx | 2000 | 低于则开 |
| 40009 | 8 | 补光回差 | 1 lx | 1000 | 高于 阈值+回差 则关 |
| 40010 | 9 | 灌溉阈值 | 0.1% | 300 | 低于则开泵 |
| 40011 | 10 | 灌溉回差 | 0.1% | 150 | 高于 阈值+回差 则关泵 |
| 40012 | 11 | 从站地址 | 1~247 | 4 | 修改后重启生效 |

### 3.2 命令寄存器

| PLC 地址 | 协议偏移 | 名称 | 写值 | 动作 |
|---|---|---|---|---|
| 40020 | 19 | 系统命令 | 0x5A5A | 触发 OTA 流程（置标志+软复位） |
| 40020 | 19 | 系统命令 | 0xA5A5 | 软件复位 |
| 40020 | 19 | 系统命令 | 0x00FF | 保存参数到 Flash（手动触发） |
| 40021 | 20 | 报警确认 | 0x01 | 清除可确认报警（蜂鸣器停止） |

### 3.3 只读约束

- 40001~40012 范围外读写：返回 ILLEGAL DATA ADDRESS；
- 40020/40021 为命令寄存器，读返回 0。

---

## 4. 运行状态字（30007）位定义

| bit | 含义 | 说明 |
|---|---|---|
| 0 | 模式=自动 | 1 表示处于自动 |
| 1 | 模式=手动 | |
| 2 | 模式=待机 | |
| 3 | 故障中 | 任一等级故障 |
| 4 | 恢复中 | 自动重试过程 |
| 5 | 堵转报警 | |
| 6 | 传感器失效 | 任一传感器失效 |
| 7 | 上联断线 | 指定时间内无有效 Modbus 请求 |
| 8 | SD 卡错误 | 写入失败 |
| 9 | 掉电检测中 | 输入电压低于阈值 |

---

## 5. 故障代码（30010）

| 代码 | 故障 | 等级 |
|---|---|---|
| 0x0000 | 无故障 | - |
| 0x0101 | 温度传感器失效 | 严重 |
| 0x0102 | 湿度传感器失效 | 严重 |
| 0x0103 | 光照传感器失效 | 轻微 |
| 0x0104 | 土壤传感器失效 | 轻微 |
| 0x0201 | 风机堵转 | 严重 |
| 0x0202 | 补光驱动异常 | 轻微 |
| 0x0301 | 参数区校验失败 | 致命 |
| 0x0401 | SD 卡写入失败 | 轻微 |
| 0x0501 | 看门狗超时复位 | 致命 |
| 0x0601 | 掉电恢复 | 信息 |

---

## 6. 线圈（功能码 01/05，可读写）

| PLC 地址 | 协议偏移 | 名称 | 说明 |
|---|---|---|---|
| 00001 | 0 | 水泵手动启停 | 手动模式有效；自动模式由规则引擎覆盖 |
| 00002 | 1 | 补光手动启停 | 同上 |
| 00003 | 2 | 蜂鸣器确认 | 写 1 清除报警声 |
| 00004 | 3 | 执行器安全锁定 | 写 1 后禁止一切控制输出（检修模式） |

---

## 7. 与 GEC6818 HMI 对接约定（联调阶段）

- 从站地址：4（避开现有 3 台设备的 1/2/3）；
- GEC6818 轮询：读 30001~30006（每 1s），读 30007/30010（报警检测）；
- 远程配置：写 40001~40004、40005（模式）、40008~40011（阈值）；
- 报警联动：30007 bit5/6 置位 → HMI 报警列表显示（复用现有报警机制）。

---

## 8. 变更记录

| 版本 | 日期 | 变更内容 | 变更人 |
|---|---|---|---|
| V1.0 | 2026-07-31 | 首次发布 
| V1.1 | 2026-08-15 | 节点 1.7 OTA 落地确认：40020 升级触发已实现（写 0x5A5A → 写标志区 → 200ms 后软复位进 Bootloader），40001~40012 参数区寄存器不变；保持寄存器总数扩至 20
