HaiPaYanZi/Smart-Farm-Edge-Node/项目过程/臭臭.gif

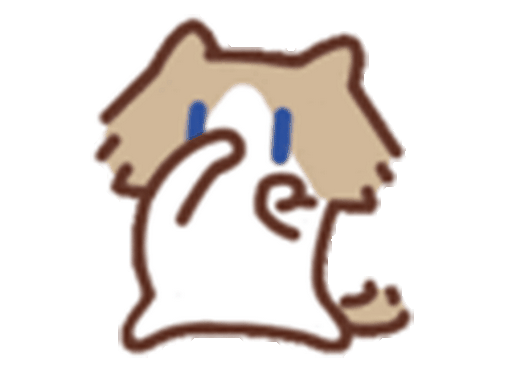
项目过程/臭臭.gif
