HaiPaYanZi/Smart-Farm-Edge-Node/project/MDK-ARM/build_ota.txt

*** Using Compiler 'V5.06 update 5 (build 528)', folder: 'D:\Keil5\ARM\ARMCC\Bin'
Build target 'project'
compiling stm32f1xx_it.c...
compiling spi.c...
compiling tim.c...
compiling adc.c...
compiling stm32f1xx_hal_gpio_ex.c...
compiling gpio.c...
compiling stm32f1xx_hal_msp.c...
compiling stm32f1xx_hal_timebase_tim.c...
compiling usart.c...
compiling main.c...
compiling freertos.c...
compiling stm32f1xx_hal_tim_ex.c...
compiling stm32f1xx_hal_tim.c...
compiling stm32f1xx_hal.c...
compiling stm32f1xx_hal_adc.c...
compiling stm32f1xx_hal_rcc_ex.c...
compiling stm32f1xx_hal_pwr.c...
compiling stm32f1xx_hal_flash.c...
compiling stm32f1xx_hal_cortex.c...
compiling stm32f1xx_hal_gpio.c...
compiling croutine.c...
compiling stm32f1xx_hal_adc_ex.c...
compiling stm32f1xx_hal_rcc.c...
compiling stm32f1xx_hal_flash_ex.c...
compiling stm32f1xx_hal_exti.c...
compiling stm32f1xx_hal_dma.c...
compiling event_groups.c...
compiling list.c...
compiling stream_buffer.c...
compiling heap_4.c...
compiling timers.c...
compiling queue.c...
compiling stm32f1xx_hal_spi.c...
compiling MySensor.c...
compiling tasks.c...
compiling port.c...
compiling param.c...
compiling rule_engine.c...
compiling stall_detect.c...
compiling modbus_reg.c...
compiling system_stm32f1xx.c...
compiling stm32f1xx_hal_uart.c...
compiling ota.c...
compiling log.c...
App\log.c(54): warning:  #186-D: pointless comparison of unsigned integer with zero
    if (level < 
OG_THRESHOLD)
App\log.c: 1 warning, 0 errors
compiling PID.c...
compiling sd_log.c...
compiling Delay.c...
compiling nvs.c...
compiling dsp_soft_IIC.c...
compiling oled_page.c...
compiling OLED_Data.c...
compiling bsp_gpio.c...
compiling debug_cmd.c...
compiling fan.c...
compiling light.c...
compiling cmsis_os2.c...
compiling bsp_pwm.c...
compiling mb.c...
compiling mbrtu.c...
FreeModbus\modbus\rtu\mbrtu.c(152): warning:  #550-D: variable "xFrameReceived"  was set but never used
      BOOL            xFrameReceived = FALSE;
FreeModbus\modbus\rtu\mbrtu.c: 1 warning, 0 errors
compiling bsp_hal_counter.c...
compiling mbcrc.c...
compiling mbfunccoils.c...
compiling mbfuncholding.c...
compiling mbfuncinput.c...
compiling portevent.c...
compiling mbfuncother.c...
compiling mbutils.c...
compiling sd_spi.c...
compiling MYOLED.c...
compiling pump.c...
compiling soil_moisture.c...
compiling AHT20.c...
compiling buzzer.c...
compiling BH1750.c...
compiling portserial.c...
compiling porttimer.c...
compiling user_diskio.c...
compiling fatfs.c...
compiling diskio.c...
compiling ff_gen_drv.c...
compiling ff.c...
compiling syscall.c...
linking...
Program Size: Code=46016 RO-data=2448 RW-data=552 ZI-data=25472  
FromELF: creating hex file...
"project\project.axf" - 0 Error(s), 2 Warning(s).
Build Time Elapsed:  00:00:15
