HaiPaYanZi/Smart-Farm-Edge-Node/project/MDK-ARM/build_log.txt

*** Using Compiler 'V5.06 update 5 (build 528)', folder: 'D:\Keil5\ARM\ARMCC\Bin'
Build target 'project'
compiling soil_moisture.c...
compiling debug_cmd.c...
linking...
Program Size: Code=46484 RO-data=2456 RW-data=556 ZI-data=25476  
FromELF: creating hex file...
"project\project.axf" - 0 Error(s), 0 Warning(s).
Build Time Elapsed:  00:00:03
