HaiPaYanZi/Smart-Farm-Edge-Node/project/Boot/MDK-ARM/build_log.txt

*** Using Compiler 'V5.06 update 5 (build 528)', folder: 'D:\Keil5\ARM\ARMCC\Bin'
Build target 'Boot'
compiling main.c...
linking...
Program Size: Code=4142 RO-data=358 RW-data=20 ZI-data=7236  
FromELF: creating hex file...
"boot\boot.axf" - 0 Error(s), 0 Warning(s).
Build Time Elapsed:  00:00:01
