HaiPaYanZi/Smart-Farm-Edge-Node/project/project.ioc

Mcu.UserName=STM32F103RCTx
PA1.Signal=ADCx_IN1
PA10.Signal=USART1_RX
PA13.Signal=SYS_JTMS-SWDIO
PA14.Signal=SYS_JTCK-SWCLK
PA2.Signal=USART2_TX
PA3.Signal=USART2_RX
PA6.Signal=S_TIM3_CH1
PA7.Signal=S_TIM3_CH2
PA8.Signal=GPIO_Output
PA9.Signal=USART1_TX
PB0.GPIO_Label=water_contorl
PB0.Signal=GPIO_Output
PB1.GPIO_Label=Hall
PB1.Signal=GPXTI1
PB10.Signal=USART3_TX
PB11.Signal=USART3_RX
PB12.Signal=GPIO_Output
PB13.Signal=SPI2_SCK
PB14.Signal=SPI2_MISO
PB15.Signal=SPI2_MOSI
PB4.GPIO_Label=BUZZER
PB4.Signal=GPIO_Output
PB6.GPIO_Label=IIC_SCL
PB6.Signal=GPIO_Output
PB7.GPIO_Label=IIC_SDA
PB7.Signal=GPIO_Output
PC0.GPIO_Label=RS485_DE
PC0.Signal=GPIO_Output
PC1.GPIO_Label=LED_signal
PC1.Signal=GPIO_Output
PC13-TAMPER-RTC.GPIO_Label=LED_runing
PC13-TAMPER-RTC.Signal=GPIO_Output
PC8.GPIO_Label=KEY2
PC8.Signal=GPIO_Input
PC9.GPIO_Label=KEY1
PC9.Signal=GPIO_Input
PD0-OSC_IN.Signal=RCC_OSC_IN
PD1-OSC_OUT.Signal=RCC_OSC_OUT
