HaiPaYanZi/Smart-Farm-Edge-Node/project/Core/Inc/main.h

#define LED_runing_Pin GPIO_PIN_13
#define LED_runing_GPIO_Port GPIOC
#define RS485_DE_Pin GPIO_PIN_0
#define RS485_DE_GPIO_Port GPIOC
#define LED_signal_Pin GPIO_PIN_1
#define LED_signal_GPIO_Port GPIOC
#define water_contorl_Pin GPIO_PIN_0
#define water_contorl_GPIO_Port GPIOB
#define Hall_Pin GPIO_PIN_1
#define Hall_GPIO_Port GPIOB
#define Hall_EXTI_IRQn EXTI1_IRQn
#define KEY2_Pin GPIO_PIN_8
#define KEY2_GPIO_Port GPIOC
#define KEY1_Pin GPIO_PIN_9
#define KEY1_GPIO_Port GPIOC
#define BUZZER_Pin GPIO_PIN_4
#define BUZZER_GPIO_Port GPIOB
#define IIC_SCL_Pin GPIO_PIN_6
#define IIC_SCL_GPIO_Port GPIOB
#define IIC_SDA_Pin GPIO_PIN_7
#define IIC_SDA_GPIO_Port GPIOB
