HaiPaYanZi/Smart-Farm-Edge-Node/project/MDK-ARM/Divece/MYOLED.c

#include "MYOLED.h"
#include "dsp_soft_IIC.h"	/* 对接工程自己的软件 I2C 驱动(Bsp 目录,函数同名 MyI2C_*) */
#include "OLED_Data.h"
#include <string.h>
#include <math.h>
#include <stdio.h>
#include <stdarg.h>

/*屏幕大小
         ←——————— 128 列 ———————→
  页0:   ████ 8个点高 (行0~7)  ████   ← 一页
  页1:   ████ 8个点高 (行8~15) ████
  页2:   ████ 8个点高 (行16~23)████
  页3:   ████ 8个点高 (行24~31)████
  页4:   ████ 8个点高 (行32~39)████
  页5:   ████ 8个点高 (行40~47)████
  页6:   ████ 8个点高 (行48~55)████
  页7:   ████ 8个点高 (行56~63)████

  - 全屏 64 行 ÷ 8 = 8 页,页号 0~7
  - 页 0~1 = 蓝色区,页 2~7 = 黄色区(双色分界在这)
*/

/**
  * 数据存储格式：
  * 纵向8点，高位在下，先从左到右，再从上到下
  * 每一个Bit对应一个像素点
  *
  *      B0 B0                  B0 B0
  *      B1 B1                  B1 B1
  *      B2 B2                  B2 B2
  *      B3 B3  ------------->  B3 B3 --
  *      B4 B4                  B4 B4  |
  *      B5 B5                  B5 B5  |
  *      B6 B6                  B6 B6  |
  *      B7 B7                  B7 B7  |
  *                                    |
  *  -----------------------------------
  *  |
  *  |   B0 B0                  B0 B0
  *  |   B1 B1                  B1 B1
  *  |   B2 B2                  B2 B2
  *  |   B3 B3  ------------->  B3 B3
  *      B4 B4                  B4 B4
  *      B5 B5                  B5 B5
  *      B6 B6                  B6 B6
  *      B7 B7                  B7 B7
  *
  * 坐标轴定义：
  * 左上角为(0, 0)点
  * 横向向右为X轴，取值范围：0~127
  * 纵向向下为Y轴，取值范围：0~63
  *
  *       0             X轴           127
  *      .------------------------------->
  *    0 |
  *      |
  *      |
  *      |
  *  Y轴 |
  *      |
  *      |
  *      |
  *   63 |
  *      v
  *
  */


  /*全局变量*********************/

  /**
    * OLED显存数组
    * 所有的显示函数，都只是对此显存数组进行读写
    * 随后调用OLED_Update函数或OLED_UpdateArea函数
    * 才会将显存数组的数据发送到OLED硬件，进行显示
    */
  uint8_t OLED_DisplayBuf[8][128];

  /*********************全局变量*/


  /*通信协议*********************/

  /**
    * 函    数：OLED写命令
    * 参    数：Command 要写入的命令值，范围：0x00~0xFF
    * 返 回 值：无
    */
  void OLED_WriteCommand(uint8_t Command)
  {
      /*使用STM32 HAL库的I2C通信函数，通过dsp_soft_IIC软件I2C模块向OLED写入命令*/
      MyI2C_WriteReg(OLED_ADDRESS, 0x00, Command);
  }

  /**
    * 函    数：OLED写数据
    * 参    数：Data 要写入数据的起始地址
    * 参    数：Count 要写入数据的数量
    * 返 回 值：无
    */
  void OLED_WriteData(uint8_t *Data, uint8_t Count)
  {
      uint8_t i;

      /*使用STM32 HAL库的I2C通信函数，通过dsp_soft_IIC软件I2C模块向OLED写入数据*/
      MyI2C_Start();							//I2C起始
      MyI2C_SendByte(OLED_ADDRESS);			//发送OLED的I2C从机地址
      MyI2C_ReceiveAck();						//接收应答
      MyI2C_SendByte(0x40);					//控制字节，给0x40，表示即将写数据
      MyI2C_ReceiveAck();						//接收应答
      /*循环Count次，进行连续的数据写入*/
      for (i = 0; i < Count; i ++)
      {
          MyI2C_SendByte(Data[i]);				//依次发送Data的每一个数据
          MyI2C_ReceiveAck();					//接收应答
      }
      MyI2C_Stop();							//I2C终止
  }

  /*********************通信协议*/


  /*硬件配置*********************/

  /**
    * 函    数：OLED设置显示光标位置
    * 参    数：Page 指定光标所在的页，范围：0~7
    * 参    数：X 指定光标所在的X轴坐标，范围：0~127
    * 返 回 值：无
    * 说    明：OLED默认的Y轴，只能8个Bit为一组写入，即1页等于8个Y轴坐标
    */
  void OLED_SetCursor(uint8_t Page, uint8_t X)
  {
      /*如果使用此程序驱动1.3寸的OLED显示屏，则需要解除此注释*/
      /*因为1.3寸的OLED驱动芯片（SH1106）有132列*/
      /*屏幕的起始列接在了第2列，而不是第0列*/
      /*所以需要将X加2，才能正常显示*/
  //	X += 2;

      /*通过指令设置页地址和列地址*/
      OLED_WriteCommand(0xB0 | Page);					//设置页位置
      OLED_WriteCommand(0x10 | ((X & 0xF0) >> 4));	//设置X位置高4位
      OLED_WriteCommand(0x00 | (X & 0x0F));			//设置X位置低4位
  }

  /**
    * 函    数：OLED初始化
    * 参    数：无
    * 返 回 值：无
    * 说    明：使用前，需要调用此初始化函数
    */
  void OLED_Init(void)
  {
      /*I2C引脚初始化已在MyI2C_Init()中完成，无需在此重复初始化*/

      /*写入一系列的命令，对OLED进行初始化配置*/
      OLED_WriteCommand(0xAE);	//设置显示开启/关闭，0xAE关闭，0xAF开启

      OLED_WriteCommand(0xD5);	//设置显示时钟分频比/振荡器频率
      OLED_WriteCommand(0x80);	//0x00~0xFF

      OLED_WriteCommand(0xA8);	//设置多路复用率
      OLED_WriteCommand(0x3F);	//0x0E~0x3F

      OLED_WriteCommand(0xD3);	//设置显示偏移
      OLED_WriteCommand(0x00);	//0x00~0x7F

      OLED_WriteCommand(0x40);	//设置显示开始行，0x40~0x7F

      OLED_WriteCommand(0xA1);	//设置左右方向，0xA1正常，0xA0左右反置

      OLED_WriteCommand(0xC8);	//设置上下方向，0xC8正常，0xC0上下反置

      OLED_WriteCommand(0xDA);	//设置COM引脚硬件配置
      OLED_WriteCommand(0x12);

      OLED_WriteCommand(0x81);	//设置对比度
      OLED_WriteCommand(0xCF);	//0x00~0xFF

      OLED_WriteCommand(0xD9);	//设置预充电周期
      OLED_WriteCommand(0xF1);

      OLED_WriteCommand(0xDB);	//设置VCOMH取消选择级别
      OLED_WriteCommand(0x30);

      OLED_WriteCommand(0xA4);	//设置整个显示打开/关闭

      OLED_WriteCommand(0xA6);	//设置正常/反色显示，0xA6正常，0xA7反色

      OLED_WriteCommand(0x8D);	//设置充电泵
      OLED_WriteCommand(0x14);

      OLED_WriteCommand(0xAF);	//开启显示

      OLED_Clear();				//清空显存数组
      OLED_Update();				//更新显示，清屏，防止初始化后未显示内容时花屏
  }

  /*********************硬件配置*/


  /*工具函数*********************/

  /*工具函数仅供内部部分函数使用*/

  /**
    * 函    数：次方函数
    * 参    数：X 底数
    * 参    数：Y 指数
    * 返 回 值：等于X的Y次方
    */
  uint32_t OLED_Pow(uint32_t X, uint32_t Y)
  {
      uint32_t Result = 1;	//结果默认为1
      while (Y --)			//累乘Y次
      {
          Result *= X;		//每次把X累乘到结果上
      }
      return Result;
  }


  /*********************工具函数*/


  /*功能函数*********************/

  /**
    * 函    数：将OLED显存数组更新到OLED屏幕
    * 参    数：无
    * 返 回 值：无
    * 说    明：所有的显示函数，都只是对OLED显存数组进行读写
    *           随后调用OLED_Update函数或OLED_UpdateArea函数
    *           才会将显存数组的数据发送到OLED硬件，进行显示
    *           故调用显示函数后，要想真正地呈现在屏幕上，还需调用更新函数
    */
  void OLED_Update(void)
  {
      uint8_t j;
      /*遍历每一页*/
      for (j = 0; j < 8; j ++)
      {
          /*设置光标位置为每一页的第一列*/
          OLED_SetCursor(j, 0);
          /*连续写入128个数据，将显存数组的数据写入到OLED硬件*/
          OLED_WriteData(OLED_DisplayBuf[j], 128);
      }
  }

  /**
    * 函    数：将OLED显存数组部分更新到OLED屏幕
    * 参    数：X 指定区域左上角的横坐标，范围：-32768~32767，屏幕区域：0~127
    * 参    数：Y 指定区域左上角的纵坐标，范围：-32768~32767，屏幕区域：0~63
    * 参    数：Width 指定区域的宽度，范围：0~128
    * 参    数：Height 指定区域的高度，范围：0~64
    * 返 回 值：无
    * 说    明：此函数会至少更新参数指定的区域
    *           如果更新区域Y轴只包含部分页，则同一页的剩余部分会跟随一起更新
    * 说    明：所有的显示函数，都只是对OLED显存数组进行读写
    *           随后调用OLED_Update函数或OLED_UpdateArea函数
    *           才会将显存数组的数据发送到OLED硬件，进行显示
    *           故调用显示函数后，要想真正地呈现在屏幕上，还需调用更新函数
    */
  void OLED_UpdateArea(int16_t X, int16_t Y, uint8_t Width, uint8_t Height)
  {
      int16_t j;
      int16_t Page, Page1;

      /*负数坐标在计算页地址时需要加一个偏移*/
      /*(Y + Height - 1) / 8 + 1的目的是(Y + Height) / 8并向上取整*/
      Page = Y / 8;
      Page1 = (Y + Height - 1) / 8 + 1;
      if (Y < 0)
      {
          Page -= 1;
          Page1 -= 1;
      }

      /*遍历指定区域涉及的相关页*/
      for (j = Page; j < Page1; j ++)
      {
          if (X >= 0 && X <= 127 && j >= 0 && j <= 7)		//超出屏幕的内容不显示
          {
              /*设置光标位置为相关页的指定列*/
              OLED_SetCursor(j, X);
              /*连续写入Width个数据，将显存数组的数据写入到OLED硬件*/
              OLED_WriteData(&OLED_DisplayBuf[j][X], Width);
          }
      }
  }

  /**
    * 函    数：将OLED显存数组全部清零
    * 参    数：无
    * 返 回 值：无
    * 说    明：调用此函数后，要想真正地呈现在屏幕上，还需调用更新函数
    */
  void OLED_Clear(void)
  {
      uint8_t i, j;
      for (j = 0; j < 8; j ++)				//遍历8页
      {
          for (i = 0; i < 128; i ++)			//遍历128列
          {
              OLED_DisplayBuf[j][i] = 0x00;	//将显存数组数据全部清零
          }
      }
  }

  /**
    * 函    数：将OLED显存数组部分清零
    * 参    数：X 指定区域左上角的横坐标，范围：-32768~32767，屏幕区域：0~127
    * 参    数：Y 指定区域左上角的纵坐标，范围：-32768~32767，屏幕区域：0~63
    * 参    数：Width 指定区域的宽度，范围：0~128
    * 参    数：Height 指定区域的高度，范围：0~64
    * 返 回 值：无
    * 说    明：调用此函数后，要想真正地呈现在屏幕上，还需调用更新函数
    */
  void OLED_ClearArea(int16_t X, int16_t Y, uint8_t Width, uint8_t Height)
  {
      int16_t i, j;

      for (j = Y; j < Y + Height; j ++)		//遍历指定页
      {
          for (i = X; i < X + Width; i ++)	//遍历指定列
          {
              if (i >= 0 && i <= 127 && j >=0 && j <= 63)				//超出屏幕的内容不显示
              {
                  OLED_DisplayBuf[j / 8][i] &= ~(0x01 << (j % 8));	//将显存数组指定数据清零
              }
          }
      }
  }

  /**
    * 函    数：将OLED显存数组全部取反
    * 参    数：无
    * 返 回 值：无
    * 说    明：调用此函数后，要想真正地呈现在屏幕上，还需调用更新函数
    */
  void OLED_Reverse(void)
  {
      uint8_t i, j;
      for (j = 0; j < 8; j ++)				//遍历8页
      {
          for (i = 0; i < 128; i ++)			//遍历128列
          {
              OLED_DisplayBuf[j][i] ^= 0xFF;	//将显存数组数据全部取反
          }
      }
  }

  /**
    * 函    数：将OLED显存数组部分取反
    * 参    数：X 指定区域左上角的横坐标，范围：-32768~32767，屏幕区域：0~127
    * 参    数：Y 指定区域左上角的纵坐标，范围：-32768~32767，屏幕区域：0~63
    * 参    数：Width 指定区域的宽度，范围：0~128
    * 参    数：Height 指定区域的高度，范围：0~64
    * 返 回 值：无
    * 说    明：调用此函数后，要想真正地呈现在屏幕上，还需调用更新函数
    */
  void OLED_ReverseArea(int16_t X, int16_t Y, uint8_t Width, uint8_t Height)
  {
      int16_t i, j;

      for (j = Y; j < Y + Height; j ++)		//遍历指定页
      {
          for (i = X; i < X + Width; i ++)	//遍历指定列
          {
              if (i >= 0 && i <= 127 && j >=0 && j <= 63)			//超出屏幕的内容不显示
              {
                  OLED_DisplayBuf[j / 8][i] ^= 0x01 << (j % 8);	//将显存数组指定数据取反
              }
          }
      }
  }

  /**
    * 函    数：OLED显示一个字符
    * 参    数：X 指定字符左上角的横坐标，范围：-32768~32767，屏幕区域：0~127
    * 参    数：Y 指定字符左上角的纵坐标，范围：-32768~32767，屏幕区域：0~63
    * 参    数：Char 指定要显示的字符，范围：ASCII码可见字符
    * 参    数：FontSize 指定字体大小
    *                 OLED_6X8		宽6像素，高8像素
    * 返 回 值：无
    * 说    明：调用此函数后，要想真正地呈现在屏幕上，还需调用更新函数
    */
  void OLED_ShowChar(int16_t X, int16_t Y, char Char, uint8_t FontSize)
  {
      /*统一使用6*8字库(8*16字库已精简删除)*/
      OLED_ShowImage(X, Y, 6, 8, OLED_F6x8[Char - ' ']);
  }

  /**
    * 函    数：OLED显示字符串（支持ASCII码和中文混合写入）
    * 参    数：X 指定字符串左上角的横坐标，范围：-32768~32767，屏幕区域：0~127
    * 参    数：Y 指定字符串左上角的纵坐标，范围：-32768~32767，屏幕区域：0~63
    * 参    数：String 指定要显示的字符串，范围：ASCII码可见字符或中文字符组成的字符串
    * 参    数：FontSize 指定字体大小
    *                 OLED_6X8		宽6像素，高8像素
    * 返 回 值：无
    * 说    明：显示的中文字符需要在OLED_Data.c里的OLED_CF16x16数组定义
    *           未找到指定中文字符时，会显示默认图形（一个方框，内部一个问号）
    *           中文字符统一以16*16点阵显示(6*8字库不含汉字)
    * 说    明：调用此函数后，要想真正地呈现在屏幕上，还需调用更新函数
    */
  void OLED_ShowString(int16_t X, int16_t Y, char *String, uint8_t FontSize)
  {
      uint16_t i = 0;
      char SingleChar[5];
      uint8_t CharLength = 0;
      uint16_t XOffset = 0;
      uint16_t pIndex;

      while (String[i] != '\0')	//遍历字符串
      {

  #ifdef OLED_CHARSET_UTF8						//定义字符集为UTF8
          /*此段代码的目的是，提取UTF8字符串中的一个字符，转存到SingleChar子字符串中*/
          /*判断UTF8编码第一个字节的标志位*/
          if ((String[i] & 0x80) == 0x00)			//第一个字节为0xxxxxxx
          {
              CharLength = 1;						//字符为1字节
              SingleChar[0] = String[i ++];		//将第一个字节写入SingleChar第0个位置，随后i指向下一个字节
              SingleChar[1] = '\0';				//为SingleChar添加字符串结束标志位
          }
          else if ((String[i] & 0xE0) == 0xC0)	//第一个字节为110xxxxx
          {
              CharLength = 2;						//字符为2字节
              SingleChar[0] = String[i ++];		//将第一个字节写入SingleChar第0个位置，随后i指向下一个字节
              if (String[i] == '\0') {break;}		//意外情况，跳出循环，结束显示
              SingleChar[1] = String[i ++];		//将第二个字节写入SingleChar第1个位置，随后i指向下一个字节
              SingleChar[2] = '\0';				//为SingleChar添加字符串结束标志位
          }
          else if ((String[i] & 0xF0) == 0xE0)	//第一个字节为1110xxxx
          {
              CharLength = 3;						//字符为3字节
              SingleChar[0] = String[i ++];
              if (String[i] == '\0') {break;}
              SingleChar[1] = String[i ++];
              if (String[i] == '\0') {break;}
              SingleChar[2] = String[i ++];
              SingleChar[3] = '\0';
          }
          else if ((String[i] & 0xF8) == 0xF0)	//第一个字节为11110xxx
          {
              CharLength = 4;						//字符为4字节
              SingleChar[0] = String[i ++];
              if (String[i] == '\0') {break;}
              SingleChar[1] = String[i ++];
              if (String[i] == '\0') {break;}
              SingleChar[2] = String[i ++];
              if (String[i] == '\0') {break;}
              SingleChar[3] = String[i ++];
              SingleChar[4] = '\0';
          }
          else
          {
              i ++;			//意外情况，i指向下一个字节，忽略此字节，继续判断下一个字节
              continue;
          }
  #endif

  #ifdef OLED_CHARSET_GB2312						//定义字符集为GB2312
          /*此段代码的目的是，提取GB2312字符串中的一个字符，转存到SingleChar子字符串中*/
          /*判断GB2312字节的最高位标志位*/
          if ((String[i] & 0x80) == 0x00)			//最高位为0
          {
              CharLength = 1;						//字符为1字节
              SingleChar[0] = String[i ++];		//将第一个字节写入SingleChar第0个位置，随后i指向下一个字节
              SingleChar[1] = '\0';				//为SingleChar添加字符串结束标志位
          }
          else									//最高位为1
          {
              CharLength = 2;						//字符为2字节
              SingleChar[0] = String[i ++];		//将第一个字节写入SingleChar第0个位置，随后i指向下一个字节
              if (String[i] == '\0') {break;}		//意外情况，跳出循环，结束显示
              SingleChar[1] = String[i ++];		//将第二个字节写入SingleChar第1个位置，随后i指向下一个字节
              SingleChar[2] = '\0';				//为SingleChar添加字符串结束标志位
          }
  #endif

          /*显示上述代码提取到的SingleChar*/
          if (CharLength == 1)	//如果是单字节字符
          {
              /*使用OLED_ShowChar显示此字符*/
              OLED_ShowChar(X + XOffset, Y, SingleChar[0], FontSize);
              XOffset += OLED_CHAR_WIDTH(FontSize);
          }
          else					//否则，即多字节字符
          {
              /*遍历整个字模库，从字模库中寻找此字符的数据*/
              /*如果找到最后一个字符（定义为空字符串），则表示字符未在字模库定义，停止寻找*/
              for (pIndex = 0; strcmp(OLED_CF16x16[pIndex].Index, "") != 0; pIndex ++)
              {
                  /*找到匹配的字符*/
                  if (strcmp(OLED_CF16x16[pIndex].Index, SingleChar) == 0)
                  {
                      break;		//跳出循环，此时pIndex的值为指定字符的索引
                  }
              }
              /*中文字符统一按16*16点阵显示(汉字没有6*8字模,直接查 OLED_CF16x16) */
              OLED_ShowImage(X + XOffset, Y, 16, 16, OLED_CF16x16[pIndex].Data);
              XOffset += 16;
          }
      }
  }

  /**
    * 函    数：OLED显示数字（十进制，正整数）
    * 参    数：X 指定数字左上角的横坐标，范围：-32768~32767，屏幕区域：0~127
    * 参    数：Y 指定数字左上角的纵坐标，范围：-32768~32767，屏幕区域：0~63
    * 参    数：Number 指定要显示的数字，范围：0~4294967295
    * 参    数：Length 指定数字的长度，范围：0~10
    * 参    数：FontSize 指定字体大小
    *                 OLED_6X8		宽6像素，高8像素
    * 返 回 值：无
    * 说    明：调用此函数后，要想真正地呈现在屏幕上，还需调用更新函数
    */
  void OLED_ShowNum(int16_t X, int16_t Y, uint32_t Number, uint8_t Length, uint8_t FontSize)
  {
      uint8_t i;
      for (i = 0; i < Length; i++)		//遍历数字的每一位
      {
          /*调用OLED_ShowChar函数，依次显示每个数字*/
          /*Number / OLED_Pow(10, Length - i - 1) % 10 可以十进制提取数字的每一位*/
          /*+ '0' 可将数字转换为字符格式*/
          OLED_ShowChar(X + i * OLED_CHAR_WIDTH(FontSize), Y, Number / OLED_Pow(10, Length - i - 1) % 10 + '0', FontSize);
      }
  }

  /**
    * 函    数：OLED显示有符号数字（十进制，整数）
    * 参    数：X 指定数字左上角的横坐标，范围：-32768~32767，屏幕区域：0~127
    * 参    数：Y 指定数字左上角的纵坐标，范围：-32768~32767，屏幕区域：0~63
    * 参    数：Number 指定要显示的数字，范围：-2147483648~2147483647
    * 参    数：Length 指定数字的长度，范围：0~10
    * 参    数：FontSize 指定字体大小
    *                 OLED_6X8		宽6像素，高8像素
    * 返 回 值：无
    * 说    明：调用此函数后，要想真正地呈现在屏幕上，还需调用更新函数
    */
  void OLED_ShowSignedNum(int16_t X, int16_t Y, int32_t Number, uint8_t Length, uint8_t FontSize)
  {
      uint8_t i;
      uint32_t Number1;

      if (Number >= 0)						//数字大于等于0
      {
          OLED_ShowChar(X, Y, '+', FontSize);	//显示+号
          Number1 = Number;					//Number1直接等于Number
      }
      else									//数字小于0
      {
          OLED_ShowChar(X, Y, '-', FontSize);	//显示-号
          Number1 = -Number;					//Number1等于Number取负
      }

      for (i = 0; i < Length; i++)			//遍历数字的每一位
      {
          /*调用OLED_ShowChar函数，依次显示每个数字*/
          /*Number1 / OLED_Pow(10, Length - i - 1) % 10 可以十进制提取数字的每一位*/
          /*+ '0' 可将数字转换为字符格式*/
          OLED_ShowChar(X + (i + 1) * OLED_CHAR_WIDTH(FontSize), Y, Number1 / OLED_Pow(10, Length - i - 1) % 10 + '0', FontSize);
      }
  }

  /**
    * 函    数：OLED显示十六进制数字（十六进制，正整数）
    * 参    数：X 指定数字左上角的横坐标，范围：-32768~32767，屏幕区域：0~127
    * 参    数：Y 指定数字左上角的纵坐标，范围：-32768~32767，屏幕区域：0~63
    * 参    数：Number 指定要显示的数字，范围：0x00000000~0xFFFFFFFF
    * 参    数：Length 指定数字的长度，范围：0~8
    * 参    数：FontSize 指定字体大小
    *                 OLED_6X8		宽6像素，高8像素
    * 返 回 值：无
    * 说    明：调用此函数后，要想真正地呈现在屏幕上，还需调用更新函数
    */
  void OLED_ShowHexNum(int16_t X, int16_t Y, uint32_t Number, uint8_t Length, uint8_t FontSize)
  {
      uint8_t i, SingleNumber;
      for (i = 0; i < Length; i++)		//遍历数字的每一位
      {
          /*以十六进制提取数字的每一位*/
          SingleNumber = Number / OLED_Pow(16, Length - i - 1) % 16;

          if (SingleNumber < 10)			//单个数字小于10
          {
              /*调用OLED_ShowChar函数，显示此数字*/
              /*+ '0' 可将数字转换为字符格式*/
              OLED_ShowChar(X + i * OLED_CHAR_WIDTH(FontSize), Y, SingleNumber + '0', FontSize);
          }
          else							//单个数字大于10
          {
              /*调用OLED_ShowChar函数，显示此数字*/
              /*+ 'A' 可将数字转换为从A开始的十六进制字符*/
              OLED_ShowChar(X + i * OLED_CHAR_WIDTH(FontSize), Y, SingleNumber - 10 + 'A', FontSize);
          }
      }
  }

  /**
    * 函    数：OLED显示二进制数字（二进制，正整数）
    * 参    数：X 指定数字左上角的横坐标，范围：-32768~32767，屏幕区域：0~127
    * 参    数：Y 指定数字左上角的纵坐标，范围：-32768~32767，屏幕区域：0~63
    * 参    数：Number 指定要显示的数字，范围：0x00000000~0xFFFFFFFF
    * 参    数：Length 指定数字的长度，范围：0~16
    * 参    数：FontSize 指定字体大小
    *                 OLED_6X8		宽6像素，高8像素
    * 返 回 值：无
    * 说    明：调用此函数后，要想真正地呈现在屏幕上，还需调用更新函数
    */
  void OLED_ShowBinNum(int16_t X, int16_t Y, uint32_t Number, uint8_t Length, uint8_t FontSize)
  {
      uint8_t i;
      for (i = 0; i < Length; i++)		//遍历数字的每一位
      {
          /*调用OLED_ShowChar函数，依次显示每个数字*/
          /*Number / OLED_Pow(2, Length - i - 1) % 2 可以二进制提取数字的每一位*/
          /*+ '0' 可将数字转换为字符格式*/
          OLED_ShowChar(X + i * OLED_CHAR_WIDTH(FontSize), Y, Number / OLED_Pow(2, Length - i - 1) % 2 + '0', FontSize);
      }
  }

  /**
    * 函    数：OLED显示浮点数字（十进制，小数）
    * 参    数：X 指定数字左上角的横坐标，范围：-32768~32767，屏幕区域：0~127
    * 参    数：Y 指定数字左上角的纵坐标，范围：-32768~32767，屏幕区域：0~63
    * 参    数：Number 指定要显示的数字，范围：-4294967295.0~4294967295.0
    * 参    数：IntLength 指定数字的整数位长度，范围：0~10
    * 参    数：FraLength 指定数字的小数位长度，范围：0~9，小数进行四舍五入显示
    * 参    数：FontSize 指定字体大小
    *                 OLED_6X8		宽6像素，高8像素
    * 返 回 值：无
    * 说    明：调用此函数后，要想真正地呈现在屏幕上，还需调用更新函数
    */
  void OLED_ShowFloatNum(int16_t X, int16_t Y, double Number, uint8_t IntLength, uint8_t FraLength, uint8_t FontSize)
  {
      uint32_t PowNum, IntNum, FraNum;

      if (Number >= 0)						//数字大于等于0
      {
          OLED_ShowChar(X, Y, '+', FontSize);	//显示+号
      }
      else									//数字小于0
      {
          OLED_ShowChar(X, Y, '-', FontSize);	//显示-号
          Number = -Number;					//Number取负
      }

      /*提取整数部分和小数部分*/
      IntNum = Number;						//直接赋值给整型变量，提取整数
      Number -= IntNum;						//将Number的整数减掉，防止之后将小数乘到整数时因数过大造成错误
      PowNum = OLED_Pow(10, FraLength);		//根据指定小数的位数，确定乘数
      FraNum = round(Number * PowNum);		//将小数乘到整数，同时四舍五入，避免显示误差
      IntNum += FraNum / PowNum;				//若四舍五入造成了进位，则需要再加给整数

      /*显示整数部分*/
      OLED_ShowNum(X + OLED_CHAR_WIDTH(FontSize), Y, IntNum, IntLength, FontSize);

      /*显示小数点*/
      OLED_ShowChar(X + (IntLength + 1) * OLED_CHAR_WIDTH(FontSize), Y, '.', FontSize);

      /*显示小数部分*/
      OLED_ShowNum(X + (IntLength + 2) * OLED_CHAR_WIDTH(FontSize), Y, FraNum, FraLength, FontSize);
  }

  /**
    * 函    数：OLED显示图像
    * 参    数：X 指定图像左上角的横坐标，范围：-32768~32767，屏幕区域：0~127
    * 参    数：Y 指定图像左上角的纵坐标，范围：-32768~32767，屏幕区域：0~63
    * 参    数：Width 指定图像的宽度，范围：0~128
    * 参    数：Height 指定图像的高度，范围：0~64
    * 参    数：Image 指定要显示的图像
    * 返 回 值：无
    * 说    明：调用此函数后，要想真正地呈现在屏幕上，还需调用更新函数
    */
  void OLED_ShowImage(int16_t X, int16_t Y, uint8_t Width, uint8_t Height, const uint8_t *Image)
  {
      uint8_t i = 0, j = 0;
      int16_t Page, Shift;

      /*将图像所在区域清空*/
      OLED_ClearArea(X, Y, Width, Height);

      /*遍历指定图像涉及的相关页*/
      /*(Height - 1) / 8 + 1的目的是Height / 8并向上取整*/
      for (j = 0; j < (Height - 1) / 8 + 1; j ++)
      {
          /*遍历指定图像涉及的相关列*/
          for (i = 0; i < Width; i ++)
          {
              if (X + i >= 0 && X + i <= 127)		//超出屏幕的内容不显示
              {
                  /*负数坐标在计算页地址和移位时需要加一个偏移*/
                  Page = Y / 8;
                  Shift = Y % 8;
                  if (Y < 0)
                  {
                      Page -= 1;
                      Shift += 8;
                  }

                  if (Page + j >= 0 && Page + j <= 7)		//超出屏幕的内容不显示
                  {
                      /*显示图像在当前页的内容*/
                      OLED_DisplayBuf[Page + j][X + i] |= Image[j * Width + i] << (Shift);
                  }

                  if (Page + j + 1 >= 0 && Page + j + 1 <= 7)		//超出屏幕的内容不显示
                  {
                      /*显示图像在下一页的内容*/
                      OLED_DisplayBuf[Page + j + 1][X + i] |= Image[j * Width + i] >> (8 - Shift);
                  }
              }
          }
      }
  }

  /**
    * 函    数：OLED使用printf函数打印格式化字符串（支持ASCII码和中文混合写入）
    * 参    数：X 指定格式化字符串左上角的横坐标，范围：-32768~32767，屏幕区域：0~127
    * 参    数：Y 指定格式化字符串左上角的纵坐标，范围：-32768~32767，屏幕区域：0~63
    * 参    数：FontSize 指定字体大小
    *                 OLED_6X8		宽6像素，高8像素
    * 参    数：format 指定要显示的格式化字符串，范围：ASCII码可见字符或中文字符组成的字符串
    * 参    数：... 格式化字符串参数列表
    * 返 回 值：无
    * 说    明：显示的中文字符需要在OLED_Data.c里的OLED_CF16x16数组定义
    *           未找到指定中文字符时，会显示默认图形（一个方框，内部一个问号）
    *           中文字符统一以16*16点阵显示(6*8字库不含汉字)
    * 说    明：调用此函数后，要想真正地呈现在屏幕上，还需调用更新函数
    */
  void OLED_Printf(int16_t X, int16_t Y, uint8_t FontSize, char *format, ...)
  {
      char String[256];						//定义字符数组
      va_list arg;							//定义可变参数列表数据类型的变量arg
      va_start(arg, format);					//从format开始，接收参数列表到arg变量
      vsprintf(String, format, arg);			//使用vsprintf打印格式化字符串和参数列表到字符数组中
      va_end(arg);							//结束变量arg
      OLED_ShowString(X, Y, String, FontSize);//OLED显示字符数组（字符串）
  }

  /************功能函数end**********/
