HaiPaYanZi/Smart-Farm-Edge-Node/(commit log)

2026-08-01 docs: 初始文档体系（11份企业级文档：需求/设计/流程/测试）
2026-08-19 feat: 智慧农业控制节点工程代码入库
    - Boot 寄存器级 Bootloader(8KB 内) + App(HAL/FreeRTOS/Modbus/FATFS/OTA)
    - OTA 双分区升级 + PC 工具(pack_ota/ota_tool/自测 9 项全过)
    - 栈金丝雀防护(Boot+App,1.7.4 实测闭环:340B/204B 余量充足)
    - docs 更新:10-测试用例 V1.1(回滚专项第 9 节),新增 12-扩展方案
    - 官方资料包(251M)不入库
    [引脚管理.xlsx]
2026-08-19 docs: 补全 CubeMX 重新生成后的手动同步清单
    - 05 规范新增 §5 完整清单(V1.2):IROM1 基址/USART3 中断接管/自定义组与路径/ffconf.h 三项手改
    - 恢复清单(操作卡)补全:OTA 分区基址、自定义源码组、栈大小与金丝雀核对、验证三步
    - 两份文档互相引用,防止清单漂移
2026-08-19 fix: 修复 App 从 B 区运行时 VTOR 被改回 A 区的潜伏缺陷
    - main.c BEGIN 1 删除 SCB->VTOR = Image$$ER_IROM1$$Base(编译时常量,恒=0x08010200)
    - VTOR 改由 Boot jump_to_app 统一设置(Boot/main.c:273 按目标分区设值)
    - 原因: 从 B 区(0x08020200)运行时会覆盖 Boot 设好的正确值,中断向量指向 A 区
    旧固件(靠旧固件碰巧兼容才未暴露);A 区损坏则 B 区运行中断必 HardFault
    - docs/05 §5.3 同步说明;已编译烧录实测日志正常(1.7.4)
    [main.c]
